kakemus/skaperfestivalen-machine/lasercut/README.md

# Scroll cassette — laser-cut box

The box that holds the paper strip, both spools, the light sensor and the backlight.
It later slides into the arcade cabinet as one unit.

## Files

| File | Material | What |
|---|---|---|
| `cassette_mdf_3mm.svg` | 3 mm MDF, one 570 × 400 bed | front, front doubler, left wall (motors), right wall (axles), top, bottom, back plate, 2 joint-test pieces |
| `cassette_diffuser_3mm.svg` | 3 mm opal / frosted acrylic | the diffuser |
| `make_cassette.py` | — | makes both files; change a number at the top and run `python3 lasercut/make_cassette.py` |

Red lines = cut. Blue = engrave or score (part names, where the motors and the LED matrix go).
Units are millimetres — check the laser software imports at 1:1 (the blue sheet outline is 570 × 400).

**Cut the two TEST pieces first** and push them together. They should slot in firmly by hand.
Too loose or too tight → set `KERF` in `make_cassette.py` (try 0.1), regenerate, test again.

## Cutting the big MDF boards down to laser size

The boards are 1190 × 815 mm, the laser bed 570 × 400. Each board gives **4 pieces**:

```
 1190 ──────────────────────────────────
 ┌────────────────┬────────────────┬──┐
 │   565 × 395    │   565 × 395    │  │ 815
 ├────────────────┼────────────────┤  │
 │   565 × 395    │   565 × 395    │  │
 └────────────────┴────────────────┴──┘
   (≈ 55 mm strip on the right, ≈ 20 mm along the bottom: offcuts)
```

1. Cut across the 1190 side at **565 mm** (a first cut), then again at 565 from that cut.
2. Cut each 565 × 815 strip across at **395 mm**.

565 × 395 rather than the full 570 × 400 leaves a few millimetres so a slightly crooked saw cut
still fits the bed. 2 mm MDF can be scored with a sharp knife against a steel ruler (several
passes) and snapped; 3 mm too with patience, but a table/track saw at the workshop is quicker.

**What goes on which:** the box is 3 mm (one bed piece). The 2 mm pieces are for later parts —
spacers, the coin chute, button plates, test pieces — or a lighter front doubler.

## Box size

Outer 126 × 216 × 95 mm. Window 64 × 90 mm (one screen of the strip shows through it).

## Also needed

- 2 × 6 mm wooden dowel, 126 mm long (paper guides, through both side walls)
- 2 × M3 screw ~16 mm + nuts/washers (spool axles in the right wall; washers fill the gap so the spool can't slide)
- 4–8 cable ties, max 2.5 mm wide (hold the motors to the left wall)
- the 5 mm LDR (goes in the small hole beside the window, sensor face flush with the inside)
- the 8 × 8 NeoPixel matrix (hot glue or double-sided tape inside the engraved square on the back plate)
- wood glue

## Assembly

1. Glue the **front doubler** onto the front panel's outside, holes lined up.
2. Glue **left wall, right wall, top and bottom** to the front with their finger joints.
   The front edge of each is marked. The back stays open.
3. Slide the **diffuser** into the slots halfway back before the second side wall is glued.
4. **Motors**, inside, along the left wall: rear shaft through the 8 mm hole, can pointing to the
   back, inside the engraved outline. Strap with cable ties through the small slots.
   Motor wires out through the round hole behind the motor.
5. **Spools**: push onto the motor shafts; M3 screw through the right wall into the spool's axle hole,
   washers between spool and wall.
6. **Dowels** through both walls, above and below the window. The paper runs in front of them
   (between dowels and front panel), so the screen in the window is flat.
7. **LDR** into the hole beside the window, from the front; legs come out behind the scanner housing.
8. **Back plate**: LED matrix on its inside (engraved square), wires through the slot; slide its
   tabs into the notches at the back of the side walls.
9. Mount the **scanner housing** on the front with bolts through the slots above/below the window.
10. Optional: paint the inside matte black so only the paper glows.

## Unchecked

- TT motor sizes are typical values (70 × 22.5 × 18.8 mm, shaft ~11 mm from the gearbox end).
  Hold a motor against the engraved outline before gluing.
- The scanner housing's own bracket positions weren't measured exactly — the slots are long so
  it can be bolted anywhere along them.

---

# Arcade cabinet — laser-cut box (2026-10-16)

The cabinet the cassette slides into, with the printer, buttons, bell and electronics.
Outer **380 W × 384 H × 260 D mm**. Made by `make_cabinet.py` (change a number at the top, run
`python3 lasercut/make_cabinet.py`). Same joints, colours and units as the cassette.

## Files — one per 565 × 395 laser piece

| File | Material | Parts |
|---|---|---|
| `cabinet_1_front_3mm.svg` | 3 mm | front (cassette opening, button holes), cassette shelf |
| `cabinet_2_back_3mm.svg` | 3 mm | back panel, button doubler, **joint test A + B**, 12 corner-block squares |
| `cabinet_3_sides_3mm.svg` | 3 mm | left side, right side (bell grille) |
| `cabinet_4_bottom_lid_3mm.svg` | 3 mm | bottom (placement marks), printer lid, 4 lid cleats |
| `cabinet_5_top_3mm.svg` | 3 mm | top (opening above the printer) |
| `cabinet_6_printer_shelf_3mm.svg` | 3 mm | printer shelf, 4 wedges |
| `cabinet_7_divider_2mm.svg` | **2 mm** | divider wall |

6 pieces of 3 mm + 1 piece of 2 mm.

## Before cutting

1. **Cut sheet 2 first** and push TEST A and TEST B together — same check as for the cassette.
2. The lid's cut-outs use the measured paper mouth (front edge 35 mm behind the printer's front,
   `MOUTH_FROM_FRONT`) and cover lever (front edge 58 mm back, right end 22 mm from the printer's
   right, `LEVER_FROM_FRONT`). Still: lay the cut lid on the printer and check before gluing.

## Hardware

- 4 × **M3 bolt, 10–20 mm** + 4 × **M3 nut** (back panel) — e.g. from the Clas Ohlson nut & bolt set 40-7042
- Wood glue

## Assembly

1. **Corner blocks**: glue 3 squares per block — hole, hexagon (press an M3 nut into it), hole.
2. **Box**: glue front, sides and bottom (finger joints). Slide the **divider** in (tabs into the
   bottom's slots), then the **cassette shelf** (left wall ↔ divider) and the **printer shelf**
   (divider ↔ right wall), tabs through their slots. Then the **top** (divider tabs into its slots).
   Glue the **button doubler** behind the front (blue box on the front shows where).
3. **Corner blocks** into the four back corners, flush with the back edges, nut side inwards.
4. **Wedges**: glue them in pairs (2 × 3 mm thick), then onto the printer shelf where the blue lines
   are — high end at the front. The printer stands on them; its top ends up level, 1 mm under the
   top surface, inside the top's opening.
5. **Lid**: lay it on the top over the printer, put the 4 cleats into the corners of the opening
   underneath it and glue them to the lid. The lid then drops into place and can't slide. To change
   the paper roll: lift the lid; the printer's cover opens up through the opening.
6. **Cassette** slides in from the back onto its shelf, against the lip of the front opening.
7. **Back panel**: 4 M3 bolts into the corner blocks.
