kakemus/skaperfestivalen-machine/docs/instructable/system-overview.png

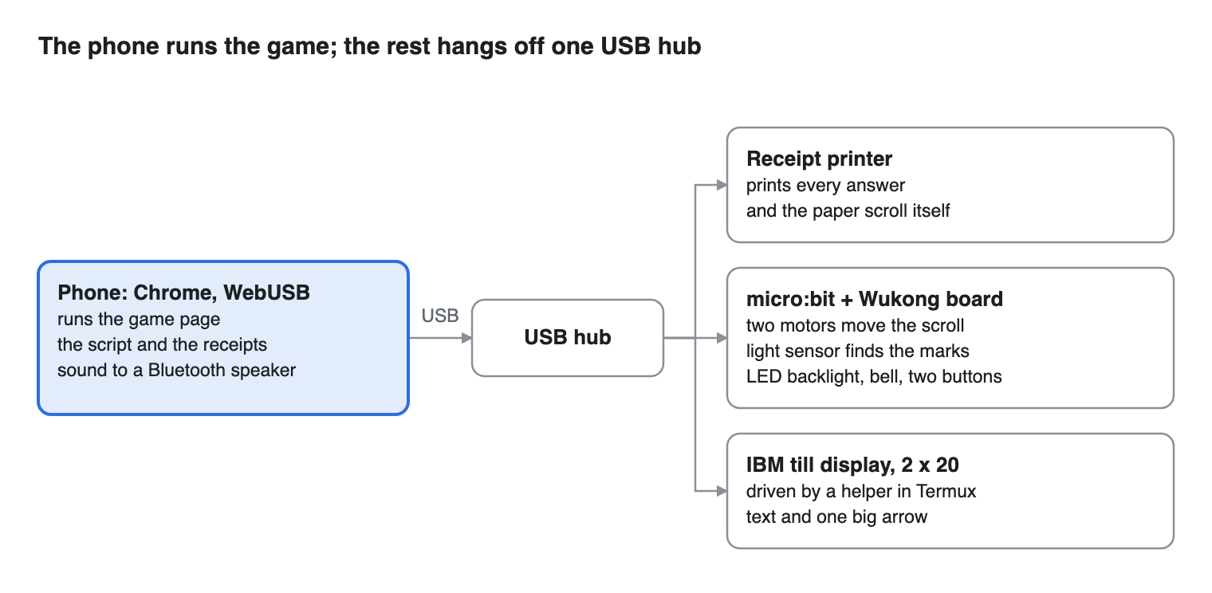
docs/instructable/system-overview.png
