kakemus/skaperfestivalen-machine/docs/scanner-enter-exit-and-reset.png

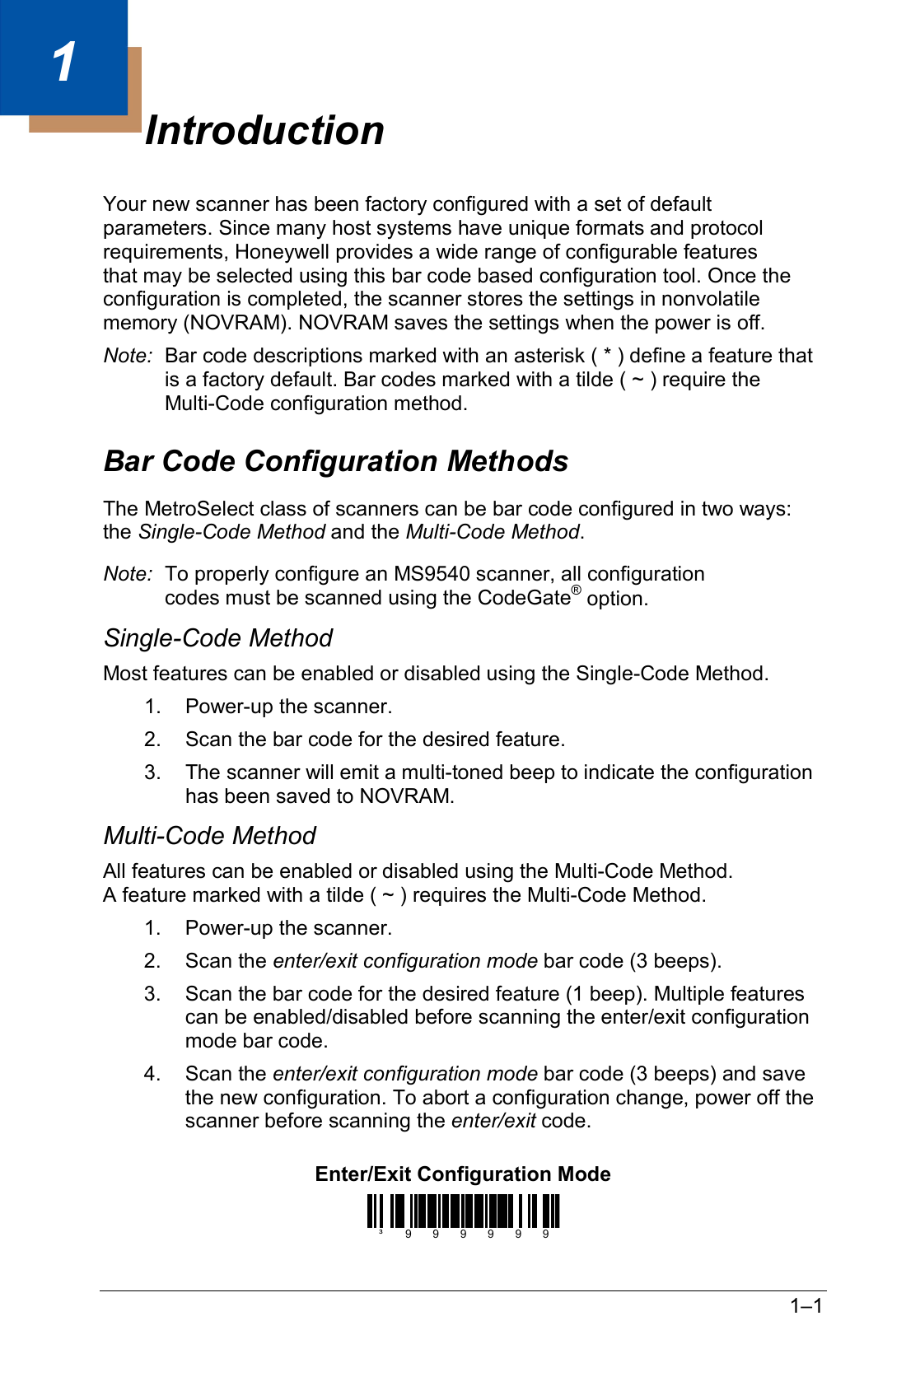
docs/scanner-enter-exit-and-reset.png
