kakemus/skaperfestivalen-machine/screens/template.png

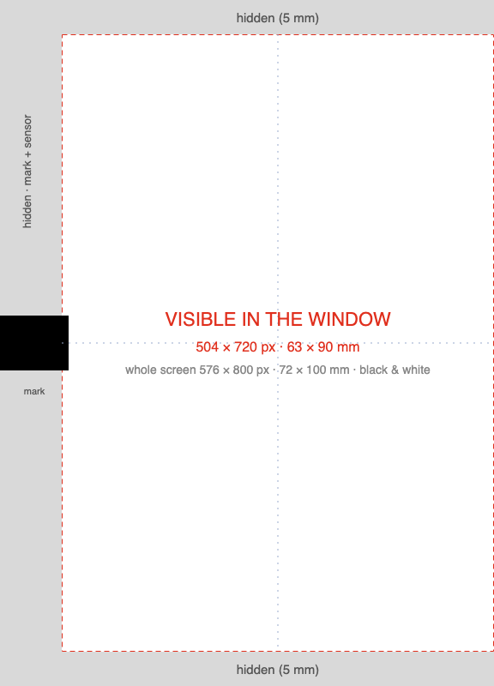
screens/template.png
