kakemus/skaperfestivalen-machine/3d/two_spools.3mf

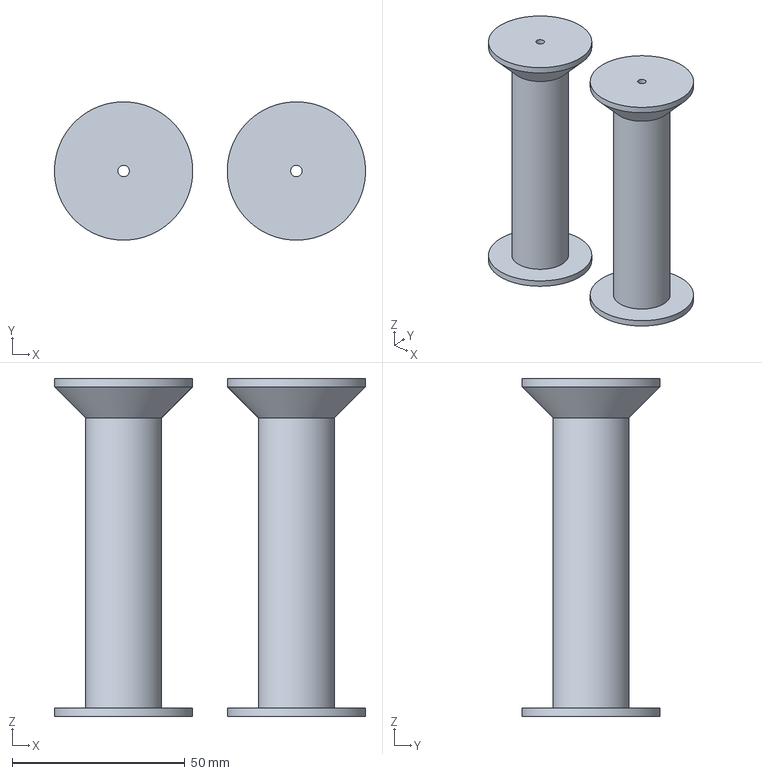
[picture p4: CAD file, 2026-10-05]
3d/two_spools.3mf
90.0 x 40.0 x 97.8 mm
spool x 2
