kakemus/skaperfestivalen-machine/3d/fit_test.3mf

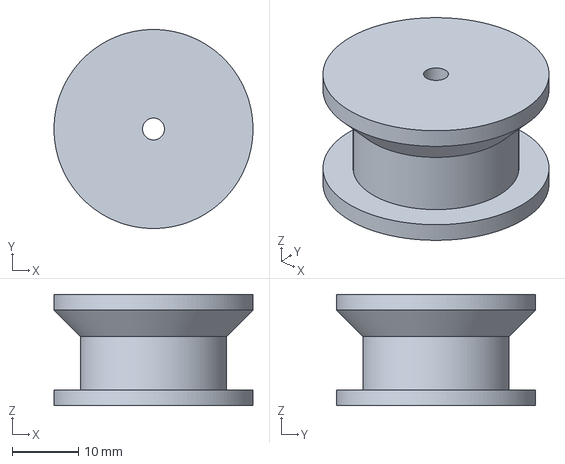
[picture p5: CAD file, 2026-10-05]
3d/fit_test.3mf
30.0 x 30.0 x 16.8 mm
