kakemus/skaperfestivalen-machine/3d/spool.stl

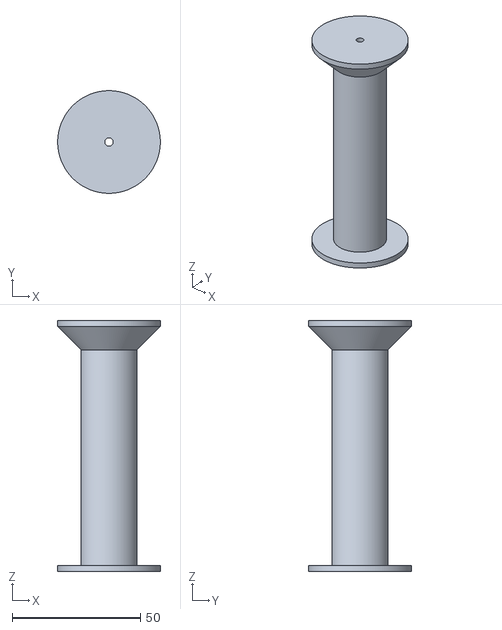
[picture p6: CAD file, 2026-10-05]
3d/spool.stl
40.0 x 40.0 x 97.8
