kakemus/skaperfestivalen-machine/(list of files, cad)

Other CAD files:
3d/two_spools.gcode.3mf
3d/fit_test.gcode.3mf
3d/spool_fit_test.stl
