kakemus/skaperfestivalen-machine/docs/instructable/laser-sheets.png

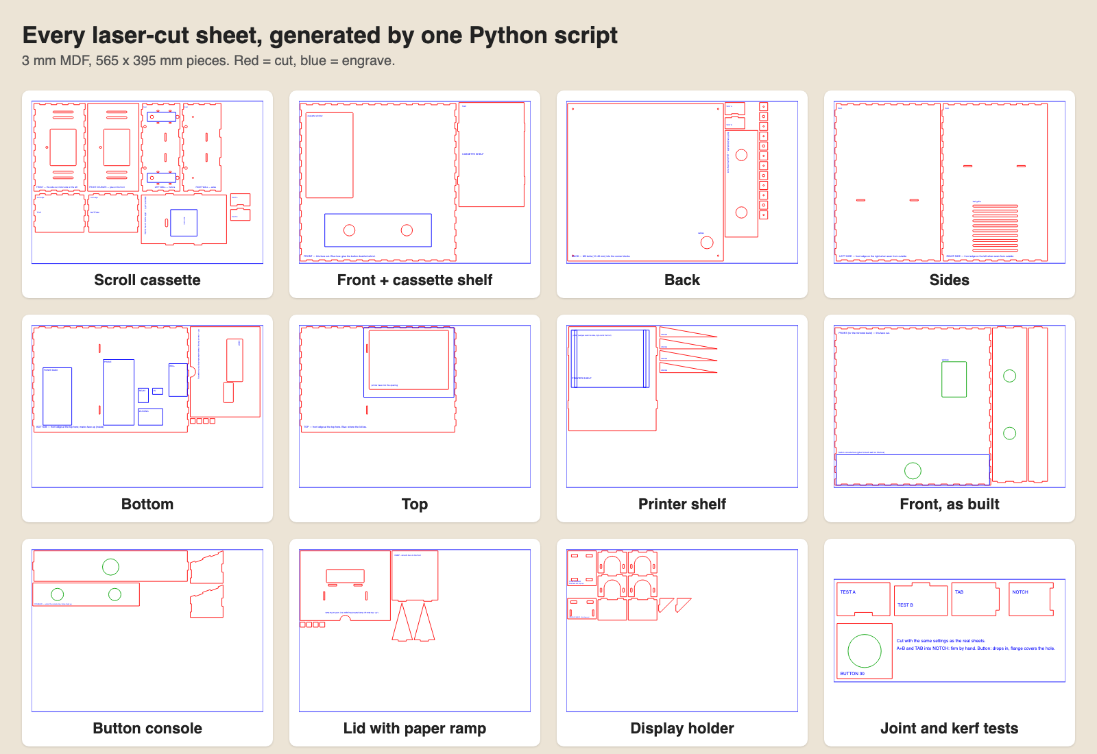
docs/instructable/laser-sheets.png
