kakemus/skaperfestivalen-machine/docs/instructable/receipt-loss.png

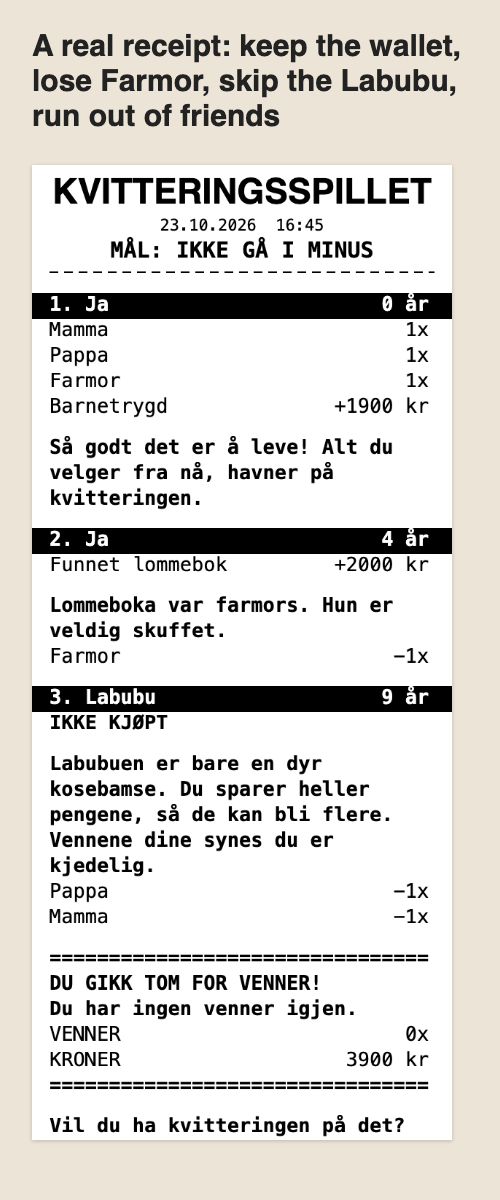
docs/instructable/receipt-loss.png
