kakemus/skaperfestivalen-machine/docs/instructable/strip-screens.png

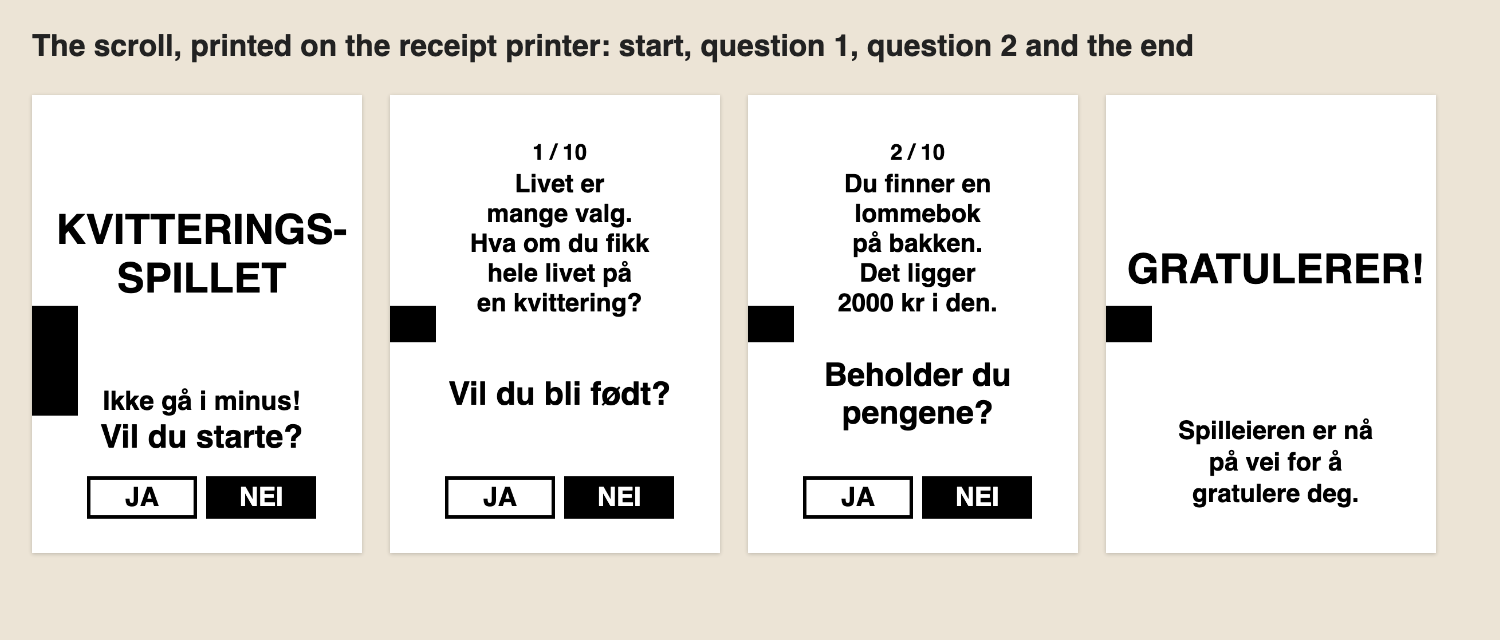
docs/instructable/strip-screens.png
