kakemus/skaperfestivalen-machine/docs/instructable/wiring.png

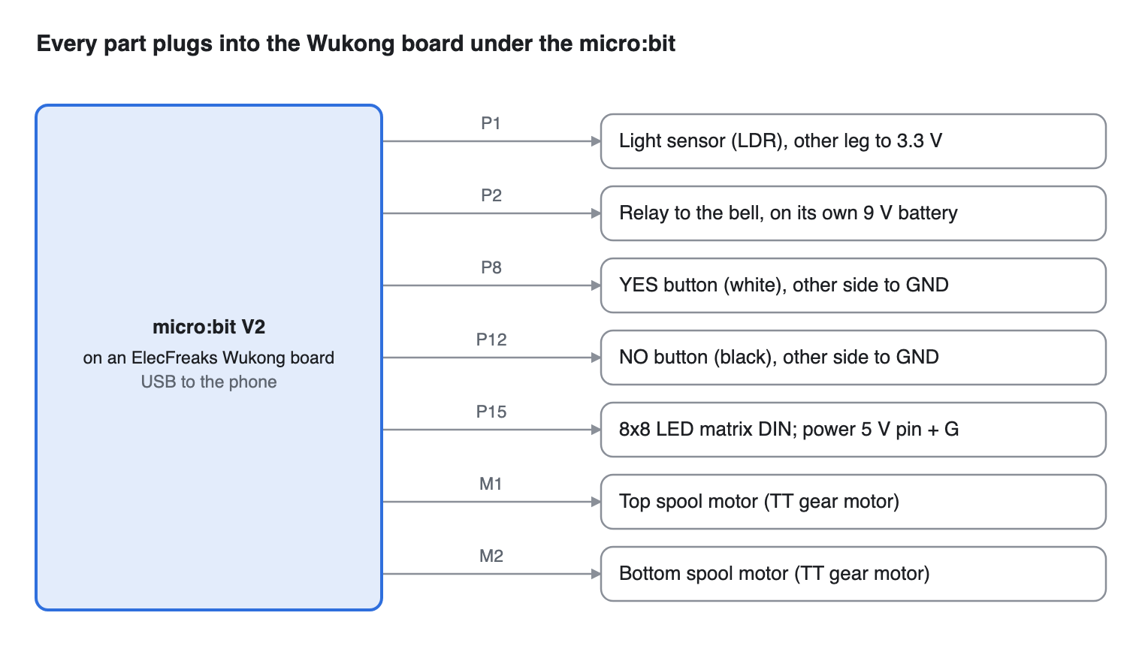
docs/instructable/wiring.png
