kakemus/skaperfestivalen-machine/docs/scanner-setup-codes.png

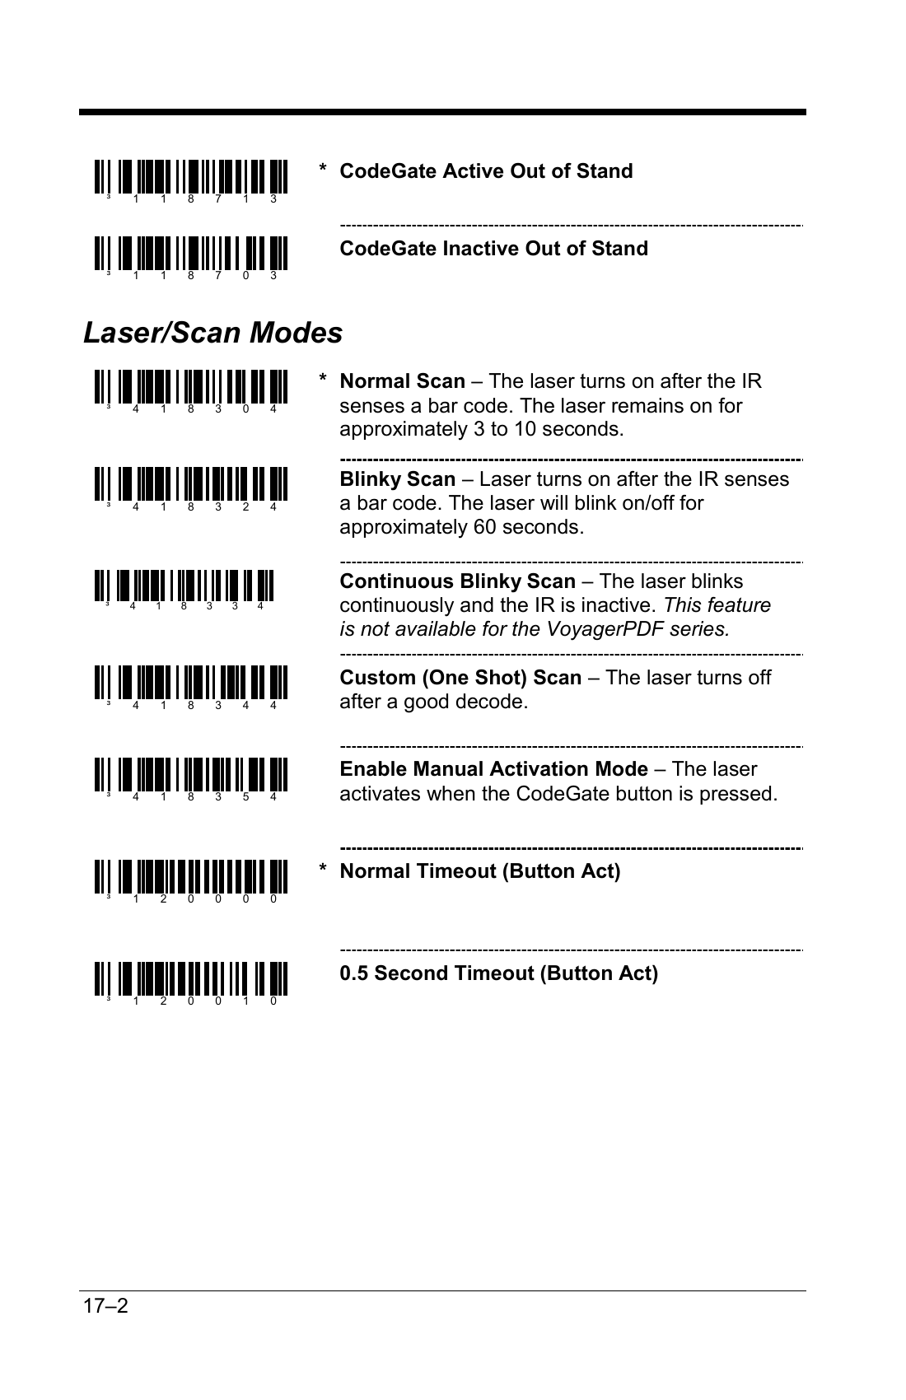
docs/scanner-setup-codes.png
