kakemus/skaperfestivalen-machine/(commit log)

2026-10-02 Start the Skaperfestivalen machine: tickets, IBM display, micro:bit
    A new project for an arcade / slot machine at Skaperfestivalen, split out of
    the occult printer so the two machines never get mixed up. Printer, raster,
    micro:bit and event-bus code are copied (not imported) from there.
    - Printer: fast by default (one transfer per ticket), slow "breathing" mode
    kept as a switch, cut stops a slow print.
    - Ticket designer: pick a design, edit its text, live preview of exactly what
    prints. Three starter designs (prize, fortune, plain).
    - IBM till display over WebHID, from the protocol worked out today by trial
    (never touches its firmware interface), with an on-screen replica and six
    an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
2026-10-02 Six wilder display scenes, and fix a crash on scene switch
    Showcase scenes for the IBM display, each squeezing the 8 custom characters:
    plasma (8 ordered-dither shades), oscilloscope (16 pixel heights across both
    lines), Pac-Man with a ghost, glitch (message breaking into noise and ROM
    glyphs), warp (stars from the middle) and rain (pixel-precise drops).
    The scene clock could hand a freshly started scene a slightly negative time,
    which made the walking bug (and would have made Pac-Man) look up a frame that
    doesn't exist and throw every tick. Clamped to zero.
    Verified: all twelve scenes run 600 simulated frames; each new one checked on
    the on-screen replica; 48 rapid scene switches with no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
2026-10-04 start.command: say why the server failed instead of opening a dead page
    On the maker's Mac a double-click opened Chrome on a page that never loaded:
    macOS privacy protection stopped Terminal from reading the Documents folder
    ("Operation not permitted"), so the server never started. The launcher now
    waits for the server, and if it is not up, prints its error, explains the
    Privacy & Security fix for that case, and waits for a key.
    Verified: script syntax-checked; the hint matches the logged error.
2026-10-04 Notes: the real game concept, replacing a misread sketch
    The maker explained the machine: a yes/no quiz on the IBM display, YES/NO
    buttons, and progress shown as a printed strip moving up behind a backlit
    window on a two-motor belt, with a bell, reward prints and a coin start.
    The notes had guessed a "test your strength" tower; future sessions should
    build towards the real thing. Notes only, no code changed.
2026-10-04 Notes: screens, rewind rule and the motors on hand
    About 10 screens, a wrong answer rewinds the belt, and the hardware is TT DC
    gear motors plus an MG90S servo. Recorded what that implies (driver board,
    separate power, registration marks with a home mark) and the open choice of
    one micro:bit for both spools vs two synced by radio. Notes only.
2026-10-04 The quiz game, playable on screen: coin, ja/nei, belt, bell, rewards
    The machine's actual game, built so it can be played on the laptop before
    the belt exists. A coin (button, C key, or any barcode scan from the
    Metrologic scanner) starts it; the IBM display asks Norwegian yes/no
    questions; a right answer moves a backlit on-screen belt up one screen,
    rings a synthesized bell and prints a reward slip; a wrong answer or running
    out of time rewinds to START; reaching the top prints a "DU VANT!" ticket.
    - belt/strip.js draws the whole printed strip with a registration mark per
    screen (START's is longer), and the sidebar can print it in one go.
    - The same moves go to the machine micro:bit as B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
    [machine.py]
2026-10-04 One tab drives the hardware; scanner detection that doesn't need Enter
    The IBM display turned to garbage and kept dropping out: two copies of the
    page were open and both wrote to it at once. A Web Lock now makes the first
    tab the only one allowed to connect to the display, printer or micro:bit
    (including automatic reconnects); another tab shows a warning and takes over
    by itself when the first one closes.
    A scan also never reached the game. Part of that was the page not having
    focus, but scanners don't all end with Enter, so a fast burst now counts as a
    scan whether it ends with Enter, Tab or nothing, and every scan is logged.
    Verified in the browser: scans ending with Enter, Tab and nothi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
2026-10-04 Scanner setup codes from the MetroSelect guide
    The handheld MS5145 only sends a code when its CodeGate button is pressed;
    the maker wants it to scan by itself. Saved the guide pages with the
    "CodeGate Inactive Out of Stand" code and the enter/exit + recall-defaults
    page (Honeywell MetroSelect Configuration Guide 00-02544) so they can be
    printed, and noted the scanner model in CLAUDE.md. Not yet tried on the
    scanner.
2026-10-04 Print the scanner's setup codes from the app
    The maker wanted the "scan without pressing the button" code on paper without
    hunting for a printer. A new "Scanner setup codes" ticket design (and a
    button under Game) prints the MS5145's MetroSelect codes on the thermal
    printer: CodeGate off/on, enter/exit setup, blinky/continuous/normal scan and
    factory reset. The barcodes are drawn as Code 128 with wide 0.5 mm bars
    rather than printing a picture of the guide page, so a laser reads them
    easily.
    Verified: the guide's own barcodes were decoded from its PDF, and the codes
    the app draws decode to the identical symbols, checksums included (118703,
    418334, 999999, 999998); the button shows the slip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
2026-10-04 Send long prints in 512-row bands
    Printing the ~1.3 m belt strip produced rows of random letters: the whole
    strip went to the printer as one raster image of ~10,000 rows, the printer
    has a limit on how tall a single image may be, and past it falls out of
    image mode and prints the bytes as text. Tickets were short enough not to
    hit it. Fast prints now go out as images of at most 512 rows (6.4 cm), sent
    back to back; the printer lays them end to end with no gap. Slow mode
    already sent 8-row strips and is unchanged.
    Verified with a fake USB printer in the browser: the default strip (10,080
    rows) went out as 20 images, none taller than 512 rows, adding up to the
    full height, and the bits are id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
2026-10-05 Belt test: timed steps without the LDR, and motor test buttons
    The maker has the micro:bits and the Wukong board ready but no light sensor
    wired yet, and wants to try the motors now. The machine firmware gets a
    USE_LDR switch (off for now: a step is a fixed run time) plus MOTOR, LIGHT?
    and PING commands, and the page a "Belt test" section to run each motor
    either way, step up/back and read the light sensor, with the board's
    answers in the log.
    Also checked the Wukong motor command against ElecFreaks' own pxt-wukong
    code (I2C 0x10, [motor, direction, speed, 0]) - identical.
    Verified: firmware syntax-checked; the page's new buttons work and say
    "No micro:bit connected" without one; no consol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
    [machine.py]
2026-10-05 Ready-to-flash micro:bit files; boards show R and M
    The maker isn't a programmer and flashing from here failed (macOS denied
    this session access to the MICROBIT drive), so the firmware now ships as
    .hex files to drag onto the board in Finder. The receiver shows "R" and the
    machine board "M", so the two look different at a glance; the receiver's
    traffic blink moved to the corner so it doesn't break the letter.
    Verified: each hex was built with uflash 2.0.0 and contains its script
    (checked by decoding the hex data). Not yet flashed onto a board.
    [machine.py, receiver.py]
2026-10-05 Machine board keeps running when the Wukong is off
    Flashed onto the real board, the machine firmware died at startup with
    OSError ENODEV: its first motor stop() couldn't reach the Wukong (switched
    off, or the micro:bit not seated), and the whole program stopped. Motor
    writes now catch that, report WUKONG:OFF once (and WUKONG:ON when it comes
    back), and belt/motor commands answer with "Wukong is off" instead of
    silently failing. The page logs these lines.
    Verified on the hardware: receiver flashed and running main.py (checked
    over its REPL); machine board flashed, reports WUKONG:OFF at startup, answers
    PING with PONG and LIGHT? with a reading, and a motor command with the
    Wukong off returns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
    [machine.py]
2026-10-05 Notes: motors confirmed working, and the Wukong seating gotcha
    M1 ran forward and back from the machine board, directly over USB and from
    the page. Recorded that a micro:bit seated the wrong way round in the Wukong
    looks like an empty I2C scan / ENODEV, so the next session checks that first.
2026-10-05 3D-printable belt spool for the TT motors
    The maker asked how to fix the paper strip to the motors. A spool that
    pushes onto the TT motor's double-flat shaft: 80 mm paper between two
    flanges, 22 mm core to tape the strip to, an M3 axle hole at the far end.
    The top flange is a 45° cone so it prints standing up with no supports.
    No 3D software is installed, so make_spool.py writes the STL itself;
    spool.scad is the same part for OpenSCAD, preview.html shows it.
    Verified: the STL is watertight (every edge shared exactly twice), its
    volume matches the hand calculation, and the measured holes are 5.5 mm with
    3.8 mm flats and 3.3 mm; checked visually in the preview. Not yet printed.
    Co-Authored-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
    [spool.scad, spool.stl]
2026-10-05 Strip as a scroll: 20 cm glue-on ends, adjustable
    The maker clarified the strip works like a scroll between two spools, not a
    loop, with extra blank paper at each end to glue to the cores. The leaders
    go from 8 to 20 cm by default with a slider (5-50 cm), and each end gets a
    dashed "LIM HER -> ØVERSTE/NEDERSTE SPOLE" zone so it's clear which end goes
    on which spool. Wording in the sidebar changed from belt to strip/scroll;
    the motor logic already worked this way.
    Verified in the browser: the strip preview shows the glue zone and arrow at
    the top, the info line reads 150 cm with 20 cm at each end, no console
    errors.
2026-10-05 Spool fit-test ring
    The shaft hole is sized from typical TT motor measurements, and printers
    vary by tenths of a millimetre, so a 17 mm ring with just the motor hole
    (about 10 minutes to print) checks the fit before printing two full spools.
    make_spool.py test writes it; the full spool.stl is byte-identical.
    Verified: both STLs watertight; spool.stl unchanged in git.
    [spool_fit_test.stl]
2026-10-05 Ready-arranged 3MF plates for Bambu Studio
    The maker is new to Bambu Studio and the school printer model is not known
    yet, so the STLs can not be sliced here. make_3mf.py packs them into plates
    that open already standing and arranged: two_spools.3mf (two spools side by
    side, centred so they fit any Bambu bed) and fit_test.3mf. At the printer:
    pick the model and PLA, slice, print.
    Verified: both 3MFs parse as valid 3MF; Bambu Studio 2.x --info reads them
    as manifold, 40x40x97.8 mm, 44 cm3 per spool.
    [fit_test.3mf, two_spools.3mf]
2026-10-05 Notes: spool shaft fit confirmed on the school printer
    The fit-test ring printed on the school Bambu P2S fits the TT motor shaft
    snugly, so the spool hole sizes stay as they are; noted how files get to
    that printer (USB stick) and that Bambu Studio's config notice is expected.
    [fit_test.gcode.3mf]
2026-10-05 Live light meter for tuning the LDR
    The light sensor is now on P1, and the belt can only stop on marks if paper
    and mark read clearly differently. Belt test gets a "Live light reading"
    switch that polls LIGHT? four times a second with a bar and number, plus
    "This is paper" / "This is a mark" buttons that judge the difference
    against the firmware's 60 % threshold and say what to change if it's too
    small. Polled readings stay out of the log.
    Verified in the browser with simulated LIGHT: lines: meter shows/hides,
    bar and number update, 820 vs 240 judged clear, 820 vs 600 judged too
    close; no new console errors. Not yet tried with the real sensor.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
    [two_spools.gcode.3mf]
2026-10-05 LDR: use the micro:bit's internal pull-down
    The maker wired the bare LDR from V to P1 with no resistor to ground and,
    in MakeCode, got usable readings with "set pull pin P1 to down". Our
    firmware read 930+ even with the sensor covered. light() now switches the
    pull-down on before every reading (an analog read can clear it), so the
    internal resistor forms the divider. A real 10 kΩ to GND remains the more
    predictable option and still works.
    Also learned: flashing MakeCode onto the machine board replaces this
    firmware entirely (the light meter then got no answers); machine.hex was
    reflashed.
    Verified: firmware syntax-checked, rebuilt hex contains the change, flashed
    onto the machine board (P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
    [machine.py]
2026-10-05 Steady LDR readings: drop the first sample, take a median of 7
    With the internal pull-down the light meter jumped up and down. Logging on
    the board showed the first analog read after switching the pull-down on
    often jumps to ~930 while the following reads are steady. light() now
    throws that first read away and returns the median of 7 more; the page
    polls 7 times a second instead of 4 so the meter feels less laggy.
    Verified on the board: 20 readings at rest read 593-596 (spread 3, was
    hundreds), each LIGHT? answered in ~23 ms. Finger/mark contrast still to
    be checked by the maker with the meter.
2026-10-05 Calibrate the mark threshold from paper vs. mark; switch stop mode live
    The first real paper/mark test read 349 vs 284. The firmware's fixed rule
    (a mark is below 60 % of the paper level) would never fire on that, yet
    with readings now steady to ±4 the 65-step gap is usable in a closed,
    backlit box. So the page's "This is paper" / "This is a mark" buttons now
    send the midpoint to the board (MARKLEVEL:n), a "Stop on marks" switch
    toggles mark-stopping vs. timed steps without reflashing (STOPMODE), and
    both are re-sent whenever the micro:bit connects. The verdict compares the
    gap with the wobble measured at each button press instead of a percentage.
    Verified in the browser with simulated rea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
    [machine.py]
2026-10-05 Snug tug after each move, and motor speeds as sliders
    Keeping the paper tight is now the remaining "sync" problem (one board
    already starts and stops both motors together, and the light sensor decides
    where to stop). After every move the spool that was feeding paper out turns
    back briefly at low power to take up slack, so the window shows a flat,
    tight screen. Pull, feed and rewind speeds and the tug's strength/time are
    sliders in Belt test, sent with SPEEDS:/SNUG: when a slider is let go and
    again whenever the micro:bit connects (the board forgets them on restart).
    Verified in the browser: sliders show defaults (60/45/80, tug 30 for
    120 ms), save, and report when no board is connected; fir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
    [machine.py]
2026-10-06 Laser-cut scroll cassette
    The cardboard prototype works, and the maker has a 600 x 400 laser cutter.
    make_cassette.py generates a finger-jointed box (4 mm plywood, one sheet)
    that holds the spools, keeps the paper flat behind the window with two
    dowels, hides the light sensor and the strip's marks beside a window
    narrower than the paper, carries a 3 mm opal diffuser and a removable back
    plate for the 8x8 NeoPixel backlight, and has a doubled front with long
    slots for the heavy scanner housing. Motors sit inside on the left wall,
    located by their rear shaft through an 8 mm hole. README.md lists parts
    and assembly; two joint-test pieces come first to set the kerf.
    Verified: the generator's fi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
2026-10-12 Cassette files for 3 mm MDF on the real 570 x 400 bed
    The laser's usable bed turned out to be 570 x 400, and the material is
    3 mm and 2 mm MDF boards of 1190 x 815, not 4 mm plywood. The generator now
    takes the bed size as a setting and checks against it, the box is drawn for
    3 mm sheet (outer 126 x 216 x 95, same inside), and the file is renamed
    cassette_mdf_3mm.svg. The README explains cutting each board into four
    565 x 395 pieces.
    Verified: generator fit checks pass, parts use 538 x 360 of the 570 x 400
    bed; sheet inspected in the browser. Not cut yet.
2026-10-12 Belt test page, non-blocking firmware, self-healing connection
    After building the box the maker reported motors that sometimes stop until
    the page is refreshed, single commands that get lost (M1 forward works, M2
    back doesn't), paper falling off the spools, and calibration lost on every
    refresh. Causes found in the code: the firmware slept through every move,
    so commands arriving meanwhile overflowed the tiny serial buffer and got
    cut off, and a page write could hang so every later command queued behind
    it forever. The old "snug tug" only pulled one spool.
    - firmware/machine.py rewritten as a non-blocking state machine: keeps
    reading during moves, STOP any time, BUSY instead of overlappin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
    [machine.py]
2026-10-12 Backlight: 8x8 NeoPixel matrix on P15
    The maker wants to test the LED matrix before the belt. Added to the
    machine firmware (not yet flashed, so this rides along with the
    non-blocking rewrite): the matrix on P15, a "backlight" setting (white
    level, stored on the board, on at boot), LED:ON/OFF/RGB and LED:TEST (red,
    green, blue, white, then back), every channel capped at 120 because 64
    LEDs at full white draw about 4 A. The belt page gets a Backlight section.
    Verified: CPython simulator (boot backlight, test sequence, brightness
    change, RGB clamp, off/on; all earlier belt tests unchanged); the belt page
    against a simulated board (test locks the buttons until LED:DONE,
    brightness saved and se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
2026-10-12 Notes: LED matrix needs the 5V pin, confirmed working
    The matrix stayed dark on the Wukong's red pin rows, which are 3.3 V; it
    works with V+ on the 5V pin of the small middle header and IN on P15.
    The new non-blocking firmware is now on the machine board (heartbeats,
    settings, LED test all answered). Wiring notes corrected in the firmware,
    the belt page and CLAUDE.md; the hex is rebuilt only for the comment.
    [machine.py]
2026-10-13 Kick start for the motors
    M1 "let out" stopped turning while the board kept answering MOTOR:DONE,
    and a nudge on the spool got it going again: at speed 50 a TT motor can't
    always break loose from a standstill against a bit of friction. Every
    motor start (moves, tension, single-motor jogs) now gets full power for a
    moment (setting "kick", default 80 ms, 0 = off) before dropping to the
    asked speed. The belt page shows it under Motors & tension.
    Verified in a simulator of the micro:bit: a jog writes -100 then -50 after
    80 ms, a step kicks both motors then runs 60/45, kick 0 goes straight to
    the speed, mark-stopping and STOP unchanged. Not yet on the board: copying
    the hex to MICROBIT hung agai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
    [machine.py]
2026-10-13 Hold-to-run belt buttons; gentle tightening
    The maker wanted to hold a button to wind the belt up or down while
    testing. Two hold buttons on the belt page send HOLD:1/-1 every 250 ms
    while pressed and HOLD:0 on release (also on STOP, leaving the window or
    hiding the tab). The board runs the belt at its normal step speeds and
    stops by itself 600 ms after the last HOLD, so a lost connection can never
    leave the motors running; letting go tightens the paper.
    Also found while testing: the kick start was applied to the tightening
    tug too - both motors at full power against each other for 80 ms, a yank
    that could tear the paper or pull it off a spool. Tightening is gentle
    again; only real starts g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
    [machine.py]
2026-10-13 Belt: flip each motor's direction in software
    Both motors on the maker's build turned out wired the other way round
    (wind in let out, so up was down). Rather than rewiring, motor() now
    negates the speed when inv1/inv2 is set, so steps, hold, rewind,
    tightening, the kick and the single-motor buttons all flip together.
    The belt page has a checkbox per motor; both start ticked for this build
    and the page pushes them to the board on connect.
    Verified: simulator shows MOTOR:1:50 driving +50 before and -50 after
    SET:inv1:1, TENSION reversed too; belt page loads with no console errors;
    flashed and the board reports inv1/inv2 in SETTINGS.
    [machine.py]
2026-10-13 Belt: brake at marks, settle back onto them, ramped tightening
    The maker saw the belt stop "a while after the mark": the motors coasted
    to a stop, then the tightening tug dragged the paper further. Now a mark
    stop brakes (short reverse burst), tightens, then creeps back until the
    sensor reads the mark again - searching the other way if the tug moved
    the paper the other way - so every screen ends in the same place. The
    board logs how far it had to back up (MARK:back:Nms).
    "Tighten paper" did nothing: a steady 35 without a kick never got a TT
    motor turning. Tightening now ramps from 0 up to the tension strength
    (new defaults 55 / 400 ms; the page migrates the old 35 / 200 once), so
    it starts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
    [machine.py]
2026-10-13 Belt page: send settings one by one; say when a step is timed
    The maker's log showed "ERR:unknown ttle:1500": the burst of SET lines on
    connect overflowed the micro:bit's serial buffer and garbled a line, so
    settings now go out 40 ms apart. The same log showed every step was a
    timed one ("Stop on marks" off), which looked like stopping late at the
    mark - the log now says so on each timed step.
    Verified: belt page loads without console errors.
2026-10-13 Belt: settle smoothly - learn which way the mark is
    With marks on, the maker found it works well but sometimes "rewinds back
    and forth": the settle crept the wrong way for 1.5 s, then the other
    way. Now the edge of the mark counts as on it, each search is 600 ms,
    and the board remembers per travel direction which way found the mark
    and tries that first. The page migrates a saved 1500 to 600 once.
    machine.py outgrew uflash's 20 KB limit, so firmware/strip.py packs a
    comment-free copy for the hex; the source stays readable.
    Verified in the simulator (now with M2 and a tug that drifts either
    way): after at most one "other way" per direction, settles land on the
    first try in ~40-100 ms; stripp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
    [machine.py, strip.py]
2026-10-13 Board owns the belt: Find START, position, service mode; game page slimmed
    The maker wants the belt to run entirely on the micro:bit. The computer
    stays only for the IBM display, the printer and the questions; the game
    now just says step / find START / ring, and the board does the rest.
    - Find START (BELT:HOME): the board runs down until START's long mark,
    learning how long an ordinary mark and a screen take; from the blank
    end it searches back up. Down moves pass through each mark and settle
    onto its top edge, so up and down stops land on the same edge.
    - The board tracks the position and reports it (BELT:DONE:n, heartbeat);
    the belt page shows it instead of counting.
    - Service mod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
2026-10-14 Phone check page: can the old Android phone run the machine?
    The maker wants to try running the machine from an old Redmi Note 7
    instead of a computer. Before changing anything, this page answers it on
    the phone itself: what Chrome there supports (WebUSB / Web Serial /
    WebHID / wake lock), and real tests - print a test ticket (text, a
    picture as the tickets send it, cut), talk to the micro:bit (PING,
    light, bell, belt step), probe the fallbacks - with a Copy results
    report. A tiny server offers just this one page on the Wi-Fi (the dev
    server stays localhost-only); the starter prints the address and the
    Chrome flag needed for USB on a plain-http LAN page.
    Verified: page renders at phone size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
2026-10-14 Phone check: list every USB device Chrome can see
    On the Redmi the printer printed fine over WebUSB, but the micro:bit did
    not appear in the WebUSB picker. An unfiltered picker tells "the phone
    does not see it at all" (cable, power, adapter) apart from "Chrome hides
    it".
    Verified: page loads with no console errors; button present.
2026-10-14 Notes: the old Android phone runs printer and micro:bit over WebUSB
    Records the phone check result (Chrome 87 on Android 10: printer and a
    full belt step both worked over WebUSB, the micro:bit via its CDC serial
    port) and how the test was reached, so the next step - running the game
    from the phone - starts from facts.
2026-10-14 Phone version: the game on the phone's screen, micro:bit over WebUSB, offline copy
    The old Redmi can print and drive the belt (phone check, same day), so
    this is the machine for it:
    - core/usbSerial.js: the part of Web Serial that controller.js uses,
    rebuilt on WebUSB (the micro:bit's CDC serial port). serialApi() uses
    real Web Serial where it exists, so the Mac pages are unchanged.
    - phone.html/phone.js: the same game, belt and ticket modules, with the
    question as big as it fits on the phone screen (whole words), timer
    bar, level dots, attract lines, one tap for full screen + screen on +
    sound, and a hidden operator panel (long press top-left).
    - sw.js + manifest: the phone keeps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
2026-10-14 Belt page on the phone: calibrate live without the Mac
    The maker expects to recalibrate the belt during the festival, so the
    belt page joins the phone version: in the offline file lists, opened
    from the operator panel (same tab, so the micro:bit is handed over) with
    a "Game" link back. "Send log to the Mac" posts the log to the phone
    server, since copying text off the old phone is awkward. CLAUDE.md also
    records the step-by-step plan agreed today.
    Verified: at phone width the belt page fits with no sideways scroll and
    no console errors; Send log arrived on the Mac; all files served by the
    phone server. Not yet run on the phone.
2026-10-14 Phone: a gear button for the panel; fresh version on one reload
    On the phone, holding the top-left corner did nothing (Android Chrome
    cancels a held finger as a gesture), and after several reloads it was
    unclear which version was running. Now a small gear button opens the
    operator panel, the start screen shows the version, and the offline
    copy asks the Mac first (up to 1.5 s) before falling back to the kept
    copy - one reload gets a new version, and it still opens offline.
    Verified: at phone width the start screen shows the version and the
    gear opens the panel; in real headless Chrome a changed file arrived on
    the first load with the server up, and the page and modules loaded
    from the kept c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
2026-10-14 Backlight: a warmth setting, default more yellow
    The maker wanted the backlight more yellow. New board setting "warm"
    (0 = white, 100 = yellow) takes blue out and a little green - the LEDs'
    green is strong, so red + full green reads lime - and applies at once;
    default 70. A number field next to Brightness on the belt page, so it
    can be tuned by eye from the phone.
    Verified in the simulator: SET:warm answers and the matrix gets
    (100, 75, 0) at warm 100 / brightness 100; packed hex rebuilt; belt page
    shows the field with no console errors. Not yet seen on the real LEDs.
    [machine.py]
2026-10-14 Backlight: pick the colour by eye instead of a warmth number
    "Warmth" 70 still looked green on the real LEDs - their green is much
    brighter than their red - so the board now keeps the colour as
    cr/cg/cb (0-255, scaled by Brightness) and the belt page has a colour
    picker that sends it while dragging, so the box changes live. Default
    is an orange-leaning yellow (255, 120, 10), since that is what reads
    yellow on these LEDs.
    Verified in the simulator: SET:cr/cg/cb answer and give (100, 39, 0) at
    brightness 100 for 255/100/0; the rebuilt hex contains the new code (and
    no "warm"); on the belt page the picker shows the default and writes
    255/100/0 for #ff6400, no console errors. Not yet seen on th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
    [machine.py]
2026-10-14 micro:bit connect: a click always shows the chooser; say when it's busy
    On the phone the micro:bit could no longer be picked while the printer
    could. Once a board had been allowed, Connect reused it silently, and
    when opening it failed (another tab still holding it) nothing visible
    happened. Now a click always opens the chooser (only the automatic
    reconnect reuses the known board), and over WebUSB a failed claim closes
    the device again and says what to do: close other tabs, replug.
    Verified: belt page loads with no console errors; a fake USB device
    that refuses claimInterface gives the new message and ends closed.
    Not yet run on the phone.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
2026-10-14 Android: always reach the micro:bit over WebUSB
    On the phone, Connect opened Chrome's serial-port chooser, which found
    nothing: the Redmi's Chrome 87 now reports navigator.serial (the phone
    check said no earlier), so serialApi() picked Web Serial, which can't
    see wired devices there. On Android the WebUSB route - the one tested
    on that phone - is now always used; computers keep Web Serial.
    Verified: with an Android user agent and navigator.serial present the
    WebUSB route is chosen; on the Mac's belt page Web Serial still is; no
    console errors. Not yet run on the phone.
2026-10-14 Green / red flash on right and wrong answers
    The maker wanted the backlight to blink green on a right answer and red
    on a wrong one, before the belt moves. The board does the blinking
    (LED:FLASH:G|R, three blinks, brighter than the backlight) and holds any
    BELT command that arrives meanwhile until the normal light is back - the
    light sensor must never look for a mark in a flash colour. STOP during a
    flash restores the light and drops the waiting move. The game sends the
    flash on a right answer and on a wrong one / time out (game, Mac page
    and phone page); the belt page has Flash green / Flash red buttons.
    A colour per screen was discussed and left for later (it can work if the
    board switches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
    [machine.py]
2026-10-14 micro:bit link: clear USB stalls, reconnect after a broken read
    The phone's belt log: "Controller read error: read stall", then
    disconnected, and every press after that went nowhere (the board was
    still plugged in, so no USB connect event came to reconnect it). Likely
    trigger: backlight 120 in purple from the Wukong's 5 V pin. Now a
    stalled endpoint is cleared and read again (up to 5 in a row), and a
    read that breaks by itself makes the page try to reconnect (5 tries,
    1.5 s apart). The belt page warns about brightness above ~40 on Wukong
    power. (The purple itself was the colour saved on the phone, 255/0/255.)
    Verified with a fake WebUSB micro:bit on the belt page: a stall is
    cleared and HB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
2026-10-14 Belt can't unwind the paper; picked colours look right on the LEDs
    The maker: Find START and the coin rewind often failed and ran so far
    the paper came off the spool. A move without a mark could run for the
    whole 8 s timeout. Now no move runs more than about 1.5 screens of paper
    without a mark (learned screen times up and down, else an estimate);
    Find START from a known position counts the marks back instead of
    having to recognise START, never passes more marks than the strip has
    (new "screens" setting, belt page), and does nothing when already on
    START.
    Picked orange came out yellow: the LEDs are linear and their green is
    strong, so colours now go through a gamma curve (2.6) and green x 0.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
    [machine.py, strip.py]
2026-10-14 English mode, a win light, and coin works right after a game
    Asked by the maker in one go:
    - English mode: game/lang.js holds all the game's words, attract lines
    and ticket texts in Norwegian and English, plus an English question
    list; the phone panel switches language, each with its own list.
    - A win light: LED:WIN, a turning rainbow with sparkles for 6 s, sent on
    a win; belt moves wait for it like they do for a flash.
    - "After winning, coin didn't take the belt back to START": coin was
    ignored for the ~12 s of the win screen and rewind. Coin now starts a
    new game straight away after a win or a loss. The board also queues a
    BELT command that arrives while a move is still finishi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
    [machine.py]
2026-10-14 Bell: through a relay, adjustable length, test buttons
    The maker wired the doorbell (rings on its own 9 V) towards P2. A pin
    can't drive it - and its coil's kick-back spike could damage the pin -
    so the wiring is a relay module (IN on P2, VCC on the 5V pin) switching
    the bell's battery, now in the firmware header and on the belt page.
    New board settings: bellms (power per ding, was a fixed 250 ms) and
    bellinv for relay modules that switch on LOW; P2 is set quiet at start
    either way. Belt page: a Bell section (Ring once / 3 times, length,
    LOW checkbox); phone panel: Ring bell. The game already rings once per
    right answer and three times on a win.
    Verified in the simulator: quiet at start, tw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
    [machine.py]
2026-10-15 Firmware over USB in pieces: the program outgrew the board's memory
    The bell/win-light firmware showed a sad face: "MemoryError: memory
    allocation failed" at start-up - MicroPython parses the whole main.py
    before running it and ~17 KB no longer fit. Precompiled .mpy would avoid
    that, but this MicroPython build can't import .mpy files.
    firmware/upload.py now strips machine.py, cuts it at top-level
    statements into pieces of at most 5 KB and writes them with a small
    loader main.py that runs them one after another in the same globals, so
    only one piece is ever being parsed. It goes over the serial port (raw
    REPL, no soft reset), so no more hanging copies to the MICROBIT drive,
    and the board's s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
    [upload.py]
2026-10-15 Save point: plan for making the belt reliable
    Symptoms seen on the machine (unreliable light sensor, step down stuck on
    its screen, last screen skipped, Find START short), likely causes, and
    the agreed plan (measure with a light trace, mechanics, taller marks,
    code that tolerates a drifting signal) - written down before turning to
    the buttons, so it can be picked up later. Includes the maker's notes:
    taller marks but not wider; black bands near the sensor not the cause.
2026-10-15 Screen template for the maker's own scroll illustrations
    The maker will draw each screen of the scroll themselves. template.png /
    .svg give the exact print size (576 x 800 px = 72 x 100 mm at 8 px/mm),
    the part that shows through the cassette window (504 x 720 px from x 72,
    y 40 = 63 x 90 mm, from the cassette's window 13-77 mm across the 80 mm
    paper and the printer's centred 72 mm print width) and the mark zone,
    plus a short README with the naming convention.
    Verified: the PNG renders at exactly 576 x 800 with the zones in place.
2026-10-16 Cabinet cutting files: the arcade box around cassette, printer and bay
    The maker is starting the box. make_cabinet.py makes one SVG per 565 x 395
    laser piece (6 x 3 mm, 1 x 2 mm), with the cassette's finger-joint code
    so the same fit applies. Outer 380 x 384 x 260 mm (height 384 rather
    than 390 for 5 mm margin on the 395 mm pieces).
    The main design point, from the maker's worry about paper travel: the
    printer stands on wedges that level its sloping top, rises into an
    opening in the top panel, and a lift-off lid with cut-outs for the mouth
    and cover lever lies on top - ~4 mm from mouth to outside, no guide, and
    the printer cover opens through the opening for new rolls. The cassette
    shows thr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
2026-10-16 Cabinet: any M3 bolt 10-20 mm for the back panel
    The maker has Clas Ohlson's nut and bolt set (M3 x 10 up to M6 x 30). The
    holes were already sized for M3 (3.4 mm, nut hexagon 5.7 AF); 10 mm
    reaches the trapped nut (back 3 mm + block layer 3 mm + nut), and longer
    ones end in the third layer's hole. Only the label and README change.
2026-10-16 Cabinet lid: the measured paper mouth position (35 mm back)
    The maker measured the printer's mouth: its front edge is 35 mm behind
    the printer's front (the files assumed 22.5). The lid's mouth and lever
    cut-outs move back accordingly (mouth 44-83 mm from the box front, still
    inside the top's opening and the lid). Regenerated; checks pass.
2026-10-16 Cabinet lid: measured cover-lever position (58 mm back, right side)
    The maker measured the printer's cover lever: front edge 58 mm behind the
    printer's front, at the right (ending 22 mm from its right edge). The lid
    assumed it at the mouth's depth; its cut-out now sits at 67-91 mm from
    the box front, still within the top's opening. Regenerated; checks pass.
2026-10-16 Belt: light trace graph; step-down and flicker safeguards
    First step of the belt-reliability plan (docs/belt-reliability-plan.md):
    measure. TRACE:ON makes the board send the light reading every 20 ms
    while the belt moves; the belt page draws it with the threshold lines
    and the board's decisions, and Send log to the Mac includes the
    readings, so the paper/mark gap, wobble and sensor lag can be seen.
    Two safeguards: a down move that starts on a mark ignores darkness for
    mingap ms (the slow LDR could take the mark it just left for the next
    one), and darkness shorter than 25 ms is logged as a flicker, not a
    mark. The simulator with a slow, noisy sensor did NOT reproduce the
    reported step-down f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
    [machine.py, upload.py]
2026-10-16 Firmware fits the board's file store again: tighter packing, clean uploads
    The light-trace firmware failed to upload: OSError 28, the micro:bit's
    ~16 KB file store was full.
    - strip.py now emits only the spaces Python needs and, with --rename,
    renames the program's own names (never micro:bit or builtin names) to
    1-2 letters; the packed syntax tree must equal the original's with the
    same renaming, and names.txt maps them back to decode board errors.
    17.6 -> 12.5 KB.
    - upload.py clears every file before writing (deleting only the old
    pieces left the store fragmented: the second update ran out of space),
    keeps settings.txt and writes it back, and retries stopping the
    running firm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
    [strip.py, upload.py]
2026-10-16 Buttons: YES + NO (or A + B) together starts a game, like a coin
    Asked by the maker. A quick press of both sends COIN:1; held 5 s it
    still switches service mode (and then doesn't start a game). A lone
    press now waits 150 ms for the other before it is sent as an answer, so
    starting a game doesn't also answer with whichever went down first.
    Verified in the simulator: single YES/NO -> one answer after ~160 ms;
    both together and A+B -> only COIN:1; held 5.5 s -> SERVICE:ON only;
    YES then NO 0.4 s apart -> two answers; the coin switch unchanged.
    Not yet on the board (not plugged in).
    [machine.py]
2026-10-16 Auto-calibrate the light sensor; keep the game log readable
    "Find START fails when you lose" - the phone's game log showed why: paper
    now reads ~205-211 after the backlight was dimmed and recoloured, but the
    threshold was still from the bright light (~500). Everything read as a
    mark, so Find START believed it was already on START and stopped at once
    (BELT:DONE:0 a second after the red flash), and steps found no marks.
    CALIBRATE: the board runs up ~1.5 screens (the blank-paper limit, so it
    passes paper and at least one mark), sets level = midpoint of the
    brightest and darkest readings and hyst = a sixth of the gap, saves, and
    reports CAL:OK:paper:mark:level:hyst (or CAL:FAIL if there's no
    co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
    [machine.py]
2026-10-16 Hold the micro:bit's A + B for 3 s: auto-calibrate, then find START
    Asked by the maker after auto-calibration worked well. Only the
    micro:bit's own buttons (inside the box), not the arcade YES/NO, so
    visitors can't trigger it. The hold blocks the coin and service-mode
    gestures it overlaps with; Find START is queued to run after the
    calibration and dropped again if the calibration fails.
    Verified in the simulator: with a stale threshold, holding A+B 3.5 s
    (and 6 s) calibrates and lands on START, a tap of A+B still starts a
    game, holding the arcade buttons 5.5 s still gives service mode; the
    packed firmware with the real loader matches the source (13.6 KB).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
    [machine.py]
2026-10-16 Cabinet: room for the cassette's motors (25 mm on its right side)
    The maker found the TT motors stick 25 mm out of the cassette's right
    side (seen from the front) - the divider sat 4 mm from the cassette.
    CAS_MOTORS moves the divider to x 162 and the printer column with it
    (213 mm wide, printer 190): printer, top opening, lid, shelves and the
    bay's placement marks follow; the lid's side overlap is 13 mm so it stays
    inside the top. Asserts check the cassette + motors fit and that no bay
    mark crosses the divider. Regenerated; preview checked.
2026-10-16 Cabinet lid: finger notch cut into the lid only, not the bottom panel
    The maker spotted something wrong on sheet 4 before cutting it: the lid's
    finger notch was a whole circle centred on the lid's back edge, so its
    outer half would have cut a semicircle out of the bottom panel lying next
    to it (by the bell mark), and the label ran through it. The lid outline
    is now one path with a half-circle notch, and the label sits clear.
    Verified: rendered sheet 4 - the notch bites only into the lid, the
    bottom panel's edge is untouched; checks pass.
2026-10-16 Hold YES + NO for 10 s to auto-calibrate (no need to open the box)
    The maker would rather calibrate with the arcade buttons than open the
    machine for the micro:bit's A + B. Holding YES + NO: service mode still
    switches at 5 s; held on to 10 s it switches back and auto-calibrates,
    then finds START. Long enough that a visitor won't do it by accident (and
    it's harmless if one does). The micro:bit's A + B for 3 s still works and
    doesn't calibrate twice.
    Verified in the simulator: held 10.5 s -> SERVICE:ON, SERVICE:OFF,
    CAL:OK, BELT:DONE:0; held 6 s -> service only, and off again on the next
    6 s hold; A + B held 12 s -> one calibration, no service; a quick tap ->
    COIN:1. Packed firmware with the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
    [machine.py]
2026-10-16 The life simulator: buy your way up through life, on a printed receipt
    The maker's new concept replaces the quiz on the phone version. Fifteen
    cards, one per screen of the scroll; each is "title | price | JA or NEI |
    losing text": JA cards are purchases to make, NEI cards traps to refuse,
    so JA isn't always right (the maker's call, decided by the story rather
    than random events). The receipt is the only screen: a header at the
    start, a line per card with the running debt, and on a wrong choice or
    a timeout the losing text and the total debt, then cut and back to
    START. The last card is the jackpot: rainbow, bells, an optional ntfy
    push to the maker's phone, the final receipt (their ending, w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
    [machine.py]
2026-10-16 Cabinet assembly manual (docs/cabinet-assembly.html)
    The maker asked for a visual manual to follow at the bench. Fourteen
    steps from the corner blocks to the back panel, in the order that works
    (dry-fit first; divider and shelves before the top; cassette in from
    the back), each with a drawing generated from the cutting files'
    measurements and the part to fit now in blue, plus a parts list per
    sheet. Back views are captioned as mirrored, with a FRONT marker.
    Also published as a private claude.ai page for the phone.
    Verified: the page renders with no console errors; the shell, divider
    and lid drawings checked against the model (right side with the grille
    appears left from behind, the cassette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
2026-10-16 Assembly manual: fix the drawings' hidden parts and labels
    The drawings sorted single faces by their middles, so walls were drawn
    over things in front of them: the button holes and the doubler never
    showed, the lid's cut-outs and the bell were hidden, the cassette sat
    behind the top. Parts are now drawn back to front by a separating plane
    between each pair that overlaps on paper (real outlines, not rectangles,
    which gave contradictory orders; finger-joint overlaps use the axis of
    least overlap). Also: the wedge drawing's "25" was clipped, the lid's
    labels crossed and hit FRONT, step 3 now shows the front from inside,
    step 13 leaves the top out so the cassette and motors can be seen, and
    the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
2026-10-16 Laser files: the 4 nut squares again, to cut without kerf offset
    The laser software's kerf offset shrank the corner blocks' hexagons on
    sheet 2 so the M3 nuts didn't fit. A small 98 x 34 mm file with just
    those 4 squares fits on an offcut; the label on it says to cut with the
    offset off. Same hexagon (5.7 mm across flats) as before. Re-running the
    script leaves sheets 1-7 byte-identical (git shows no change in them).
2026-10-16 Laser files: one button hole, to cut again into the panels already cut
    The kerf offset made the button holes too small, and carving 27.5 mm
    holes round by hand is hard. Cutting a whole new front would use a full
    board piece; instead the cut front (and doubler) goes back in the laser,
    the head is centred on an old hole and this single 28 mm circle is cut
    over it, kerf offset off. Only the red circle is in the file - a blue
    outline would get engraved onto the finished front. Sheets 1-8 unchanged.
2026-10-16 Laser files: roomier hexagons in the nut-square recut (6.1 mm)
    The 5.7 mm hexagon came out too small for the M3 nut even with kerf
    offset off. The nut is glued in between two round-hole squares, so it
    only has to be kept from turning, not pressed in: 6.1 mm across flats
    still sits under the nut's 6.35 mm across corners. Only the recut file
    changes; sheet 2 is already cut and stays as it was.
2026-10-19 Laser files: a new front + doubler for the box as it was built (mirrored)
    The box went together as a mirror image of the drawings (printer on the
    left, cassette on the right, seen from the front), and the front and the
    doubler were stolen. The cassette itself is not mirrored - its motors
    still stick out of its right side - so in the right-hand column it sits
    against the divider with the motors towards the wall, as in the maker's
    photo; the window is placed for that (cassette 1 mm from the divider,
    4 mm lip). Button holes are 28 mm (27.5 came out too small). Holes and
    window are green, to cut with kerf offset off; the outline stays red
    with the offset the finger joints were tuned for. Front +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
2026-10-19 New front: a small window that frames only the cassette's paper
    The maker wants the light sensor (and its tape) and the registration marks
    hidden. The window now follows the cassette's own paper window from
    make_cassette.py (39.7-103.7 mm from its left side, 63-153 mm down from
    its top), 2 mm smaller on every side so a slightly-off cassette doesn't
    show its edges: 60 x 86 mm at x 260.7, 215-301 mm up. The maker's photo
    of the build puts the cassette window at about x 261-326 - within ~2 mm
    of this. To be confirmed with a ruler before cutting.
2026-10-19 New front: 30 mm button holes, to be sure the buttons fit
    The maker asked for 30 mm; the button's flange and nut still cover it.
    Front and doubler, both green (cut with kerf offset off).
2026-10-19 Laser files: a 20 degree button console on the new front
    The maker wanted the buttons angled up towards the player instead of flat
    in the front. A full-width wedge (80 mm deep, 50 -> 79 mm high, top at
    20 degrees) is glued to the bottom of the front: two side pieces with
    notches carry tabs on the sloped top, a front strip and a back wall; the
    back wall gives a big glue face against the front, and a 40 mm cable
    hole through both takes the button wires into the bay. The buttons (30
    mm holes) sit mid-slope with a doubler under them; a 45 mm button body
    still ends ~22 mm above the table. The front loses its button holes.
    Two sheets: 10 (front, console top, strip) and 11 (back wall, sides,
    double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
2026-10-19 Laser files: a test sheet for the new front and console
    The maker asked for tests before cutting sheets 10-11, now that kerf
    offset may be turned off: the finger joint (TEST A+B, as on sheet 2),
    the console's tab-in-notch joint (TAB+NOTCH) and one 30 mm button hole,
    110 x 87 mm. Checked by rendering it.
2026-10-19 Assembly manual: drawn as built (mirrored), with the button console
    The box was built as a mirror image of the cutting files, so the
    drawings now mirror the picture (not the viewpoint, which kept the views
    looking into the box) and every left/right in the text follows the real
    box: printer on the left, cassette on the right, seen from the front.
    New: step 3 builds the 20 degree console onto the new front (sheets
    10-11, test sheet 12 first); the renderer gained straight prisms for its
    sloped parts, with the button holes drawn on the sloped top. The
    cassette sits where it really does (against the divider, motors to the
    wall), the front shows the small window and the cable hole, the old
    doubler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
2026-10-20 Add Kvitteringsspillet, Aksel's script for the machine
    A complete life-on-a-receipt game written in a separate session, added in
    its own folder so nothing else in the project changes. The README explains
    how it could fit the machine (JA/NEI buttons, ES modules, belt screens).
    Checked: the page opens and runs on its own in a browser.
    Claude-Session: https://claude.ai/code/session_01AXoBJh6QH7jHf1Ewhkux3P
2026-10-20 Kvitteringsspillet: the motor and script as ES modules, tested against the prototype
    The machine's pages load native ES modules, while Aksel's prototype motor
    was written for Node. game/kvitteringMotor.js holds the same rules as an ES
    module and game/manus.js the script, unchanged. Both are added to the
    offline copy (sw.js cache v15, phone_server.py).
    Verified: tests/kvittering.test.mjs plays all 55 paths through the game in
    the prototype's motor and the new one and gets identical receipts (a
    deliberately broken motor makes it fail). Also checked: no receipt line is
    wider than 32 characters, at most two answers per question, and in headless
    Chromium both modules load from phone_server.py an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
    [kvitteringMotor.js]
2026-10-20 Kvitteringsspillet: a 60-second life of 67 years, and a simulator
    Aksel's rules for the machine: a whole life is 60 s = 67 years, counted
    only while the player decides (not while the machine prints or moves the
    belt), each answer printed with the player's age, the game over when the
    time is used up ("Tiden er ute. Du ble 67 år."), question 10 "Nei" answered
    with "Vil du ha kvitteringen?", and 15 s after the end for the player to
    take the receipt before the machine is ready again. game/kvittering.js runs
    it through io like the life game; every wait on the printer and the belt
    has a limit, so a stuck device can't stop the machine for the day.
    simulator.html runs the same game with an on-scree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
    [kvitteringMotor.js]
2026-10-20 Kvitteringsspillet: print the receipt line by line, 2 s per line
    Players need time to read: the receipt is the story. The game now hands
    the printer one line at a time and gives each text line 2 s (a blank line
    a quarter of that), with the life clock stopped while it prints; the belt
    shows the next question meanwhile. A printer that doesn't answer is waited
    for once (20 s) and after that only the reading pace is kept, so a stuck
    printer can't stretch one answer into minutes. The simulator types each
    line at the game's pace and shows the next question while printing.
    Verified: tests/kvittering.test.mjs measures 2 s between text lines and
    0.5 s after blank ones with the age unchanged meanwhil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
2026-10-20 Kvitteringsspillet: 0.5 s per printed line, and a printing sound
    2 s per line made a game last minutes; 0.5 s still lets players read the
    receipt as it comes out (blank lines a quarter of that). The simulator now
    makes a thermal printer's "skhsh" for every printed line (printSound() in
    game/sound.js: chopped, band-passed noise), with a sound on/off box.
    Verified: tests/kvittering.test.mjs passes (the fake printer made faster
    than the new blank-line time, and the test now looks for the next
    question every 5 ms instead of 100 ms, which had added up to a year). In
    headless Chromium: text lines 0.50 s apart, blank ones 0.13 s, and 11
    sounds for 11 printed text lines, no errors.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
2026-10-20 Simulator: black and white, a testing panel, time only on the receipt; fix the printer watch
    The simulator is redone in plain black and white (JA black, NEI white),
    without the age and life bar: the time left now only shows on the
    receipt. A testing panel (D, closable) shows kroner, venner, visning, age,
    time left, and per question which answers can still win, with a ✓ / ✗ on
    each answer given — like the panel in Aksel's prototype.
    The panel showed "Skriveren svarer ikke" over and over with a working
    printer: the 20 s watch started for each printed line was never
    cancelled, so it went off later anyway and marked the printer stuck. On
    the machine that would have made the game stop wait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
2026-10-20 Kvitteringsspillet: 5 s between games instead of 15
    The wait after a game was longer than needed to take the receipt; 5 s
    keeps the queue moving. Presses during those 5 s are still ignored, and
    the belt rewinds meanwhile (the machine waits for whichever is longer).
    Verified: tests/kvittering.test.mjs passes (the pause tests use the
    constant; the 10-hour day now fits 725 games). In headless Chromium:
    "Ny runde om 5 s", JA+NEI during the pause ignored, ready for the next
    player after 5.0 s, no errors.
    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
2026-10-20 Kvitteringsspillet on the machine: receipt drawing, question strip, phone.js switch
    The three things the branch left open. phone.js now runs createKvitteringGame
    instead of the life game: JA/NEI answer, JA+NEI (COIN) starts, the operator
    screen shows the question, which button means what, age, kroner and friends,
    and the bar runs out with the life left. game/kvitteringTegning.js sets the
    game's 32-character lines in a monospaced font sized to exactly 32 across,
    with no margins, so the one-line-per-job printing (f407377) joins into one
    seamless receipt; a big title + date on top, and the cut feeds 15 mm past the
    blade first. The scroll gets one screen per question (belt/strip.js
    cfg.screens,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
2026-10-20 Kvitteringsspillet: question 1 stands ready, the first answer starts the game
    Pressing JA and NEI together to start was one step too many: now question
    1 stands on the scroll as soon as the machine is free, and the first answer
    starts the game — the receipt header and that answer are printed, and the
    life clock runs from then on. Nothing is printed and no clock runs while
    the machine waits. After a game the 5 s for taking the receipt come first,
    then the belt rewinds (it used to rewind during the 5 s), then question 1
    is ready again. start() is now only the power-on rewind.
    Fitted to Stener's phone.js wiring (42b0854): the header is still its own
    "Start" print just before the first answer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
2026-10-20 Kvitteringsspillet: check the balance when the whole answer is done
    Aksel wanted the story to come out before the loss: on question 8 "Ja" the
    receipt jumped from the answer line straight to "SPILLET ER TAPT", because
    the motor stopped at the boat's -19000 before the funny part. The balance
    is now checked when all the answer's steps are done: kroner below 0 at the
    end lose; friends removed that weren't there are a debt that friends added
    later in the same answer pay off, else they lose; death still stops at
    once. Under the new rule the boat's pawn (9500) would have saved players
    who couldn't afford the boat, so it is 50 kr now — the richest player who
    can't afford it has 18 900 kr before q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
2026-10-20 Phone panel: the controls in use on one page, most used first
    The maker found the panel bloated: belt jobs needed a trip to the belt
    setup page with all its light-sensor, motor and test settings. The phone
    panel now has, top to bottom: Close + a red STOP; printer / micro:bit /
    belt position; the belt (step up/down, hold to wind up/down, Find START,
    Auto-calibrate — the same board commands as belt.html, holds repeated
    every 250 ms like there); the game (Reset game, JA/NEI, test print, cut,
    bell, win light); the log; the strip. The game description, push settings,
    version and the link to all belt settings sit in a closed "More" at the
    bottom, so nothing is gone. belt.html itself is unchanged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
2026-10-20 Scroll pictures: the maker's eight pictures on the question screens
    The maker found pictures for questions 3-10 (bilder/NN-name.png, named
    after manus.js's "bildefil"). They're all on plain opaque white, so each is
    prepared once in game/kvitteringTegning.js: a flood fill from the edges
    finds the background (a white object with any shading at its edge stays),
    the picture is cropped to the object and fitted into a 464 x 278 area,
    levelled (gamma 0.85), and Floyd-Steinberg dithered (raster.js's, now
    exported). Per picture: the white microscope gets a black outline round
    the object, the red chair and the brown cabinet a lighter gamma - they came
    out almost solid. belt/strip.js draws a screen's r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
2026-10-20 Strip screens: content moved into the part the front's window really shows
    The maker's photo of the first printed strip in the machine: the front's
    window sits about 5 mm left of where it was drawn, so roughly 5-65 mm of
    the paper's width shows - text past ~65 mm was cut off on the right and
    the mark's right half showed on the left. Re-cutting the front would mean
    rebuilding the console glued to it; re-printing the strip is quicker. The
    screens' content area is now 12-62 mm of the paper (WIN x 96, w 400), the
    pictures 400 x 240 to match. Cache v21.
    Verified in Chrome: screens 1, 2 and 8 drawn with the hidden parts (from
    the photo) shaded - all text, pictures and the answer band inside.
    Co-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
2026-10-20 Phone: feed each answer up into view, and Tighten paper back on the panel
    The maker's photo: the print head sits well below the printer's slot, so
    an answer's last lines stayed inside the printer while the player was
    supposed to read them. After each answer (when the game moves on to the
    next question, which it does only once the answer is printed) the phone
    now feeds 20 mm of paper; "Space under each answer (mm)" in the panel's
    Game section changes it (0-60, kept on the phone). The belt section has
    "Tighten paper" again: the board's TENSION command, as on belt.html
    (answers TENSION:DONE, or BUSY while moving). Cache v22.
    Verified in Chrome: a first answer printed as Start, the answer's lin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
2026-10-20 Phone: 30 mm under each answer instead of 20
    The maker's photo with 20 mm: the answer's last line was still under the
    printer's slot, about 1.5 lines short. 30 mm brings it up into view.
    (A value typed into the panel stays as it is.) Cache v23.
2026-10-20 Kvitteringsspillet: a life of 10 minutes instead of 60 seconds
    Testing on the machine, 60 s for the whole life - about 6 s a question,
    reading included - was far too short, and felt like the timer wasn't
    working. The maker chose to keep the idea (one clock for the whole life,
    running only while the player decides, 0 to 67 years) and make it 10x
    longer: LIVSTID_MS 600000, about a minute a question. The light's hurry
    flicker still covers the last 10 s. Two tests had 6 s = 6 years and
    3 s = 3 years written in; they now take the time from LIVSTID_MS and
    LEVEALDER, so they hold for any life length. Texts updated (comments,
    README, CLAUDE.md, the phone panel). Cache v24.
    Verified: node tests/kvit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
2026-10-20 The IBM till display on the phone: a Termux helper, and the game's countdown
    The maker wanted the life's countdown on the old IBM display. Android's
    Chrome has no WebHID and blocks HID devices from WebUSB, so a helper in
    Termux on the phone owns the display instead (tools/termux-ibm/: termux-usb
    hands it the device, libusb via ctypes, Android's HID driver detached; a
    small HTTP server on 127.0.0.1:8765). It writes only to the interface whose
    report descriptor has usage 0x2600 and not 0xA000. The display's font has
    no Æ Ø Å, so the helper draws them as custom characters 1-3.
    game/kvitteringDisplay.js turns the game's state into the two 20-character
    lines: KVITTERINGSSPILLET / SVAR JA ELLE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
2026-10-20 Kvitteringsspillet: belt waits for the receipt, 4-minute life, age instead of a timer
    From playing it on the machine: the next question ran ahead of the answer
    still printing, so the belt now moves on only once the answer is printed
    (and the phone first feeds it up out of the slot, via its belt.step, so it
    can be read while the next question comes). The life is 4 minutes (the
    clock still stops while printing). And the IBM display no longer counts
    down: it shows DU ER nn ÅR growing while the player thinks, the money or
    friends below, and SKYND DEG! blinking in the last 10 s - getting older is
    more fun to watch than a timer. Cache v27.
    Verified: node tests/kvittering.test.mjs, all ok; in Chr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
2026-10-20 IBM display: the age ticks up live; the life back to 3 minutes
    The display showed the game's own age, which only moves on with an answer,
    so it stood still while the player thought. It now works the age out from
    the life used so far (game.igjenMs counts the question being decided), so
    it climbs every ~2.7 s while the player hesitates and stops while the
    machine prints. The maker went back to a life of 3 minutes. Cache v28.
    Verified: the display lines for 180/179/150/90/2 s left (0/0/11/33/66 years)
    in node; node tests/kvittering.test.mjs all ok.
2026-10-20 Phone: a micro:bit watchdog that resets a board gone deaf
    Twice on 2026-10-20 the board stopped reacting mid-game: "M" on its LEDs
    (its idle screen), still connected over USB (Android's USB log showed no
    drop), no answer to any command until its reset button was pressed. The
    cause isn't known yet. So the phone now PINGs it every 5 s; after two
    unanswered in a row it logs when the last heartbeat came, resets the board
    the way its button does - a serial BREAK, on which the micro:bit's USB chip
    (DAPLink) restarts it (usbSerial.js sendBreak, controller.js resetBoard;
    Web Serial's setSignals on a computer) - and puts the game back on START,
    since the board lost its place. The panel shows "not ans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
2026-10-20 Phone panel: a Reset micro:bit button
    The same serial-break reset the watchdog uses, by hand - so it can be
    tried on the board without waiting for the next freeze. Cache v30.
2026-10-20 Watchdog: one automatic reset only, and the break ended for sure
    On the machine the first automatic reset didn't bring the board back, and
    the watchdog then reset it every 15 s for minutes - it never got to start,
    and the maker's own reset-button press was overridden. Now it resets once;
    if the board still doesn't answer it only says so (unplug and replug), and
    tries again only after the board has answered once more. The break is
    also explicitly ended (SEND_BREAK 0) after its 100 ms, in case a break left
    on held the board in reset. Cache v31.
2026-10-20 Phone log: keep 1500 lines instead of 150
    The log sent after a good session covered only its last minute and a half -
    too short to tell whether the board froze earlier on. Cache v33.
2026-10-20 Phone panel: the Termux command for the IBM display, with a Copy button
    After a phone restart the display's helper has to be started by hand in
    Termux; the panel now shows the command under the IBM display line, and a
    button copies it for pasting there. Cache v34.
2026-10-20 IBM display helper finds the display by itself
    "No such device": the display had been replugged and its USB path had
    changed, and Termux can't read the USB list to find the new one. The start
    script now tries each device termux-usb lists (the last path that worked
    first) with ibm_bridge.py --probe, which only reads the device descriptor,
    until one is 04b3:4526. The phone server serves the two helper files and the
    panel copies a one-line update command; the start command no longer takes a
    path. Cache v35.
2026-10-20 JA + NEI held 5 s: auto-calibrate and put the game back on START
    The maker wanted a 5 s hold of the arcade buttons to calibrate and reset
    the game. In the firmware, 5 s used to toggle service mode (S on the
    display, YES/NO winding the belt) with calibration at 10 s; service mode
    isn't needed from the buttons any more (the phone panel has hold-to-wind),
    so its button toggle is gone and calibration is at 5 s (CAL_ARCADE_MS);
    the hold no longer gives a coin on release. 220 bytes smaller packed
    (14184). On the phone, a calibration's end - CAL:OK then the board's own
    find-START reply, or CAL:FAIL - now resets the game, so it doesn't go on
    from where the belt used to be; the panel's Auto-calibrate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
    [machine.py]
2026-10-20 Watchdog: heartbeat-based, faster, and the game goes on after a reset
    The log of the next freezes (19:52, 19:58): the board's heartbeat stopped
    while a player was thinking, only with the IBM display on the hub; the
    automatic reset brought it back in 4 s, but the game started over. Now
    the watchdog goes by the heartbeat the board sends every 2 s anyway
    (instead of its own PINGs): 5 s without one → one reset (serial break);
    if the belt was standing still (ready / deciding), the board is told which
    screen it's on (POS) and the game simply goes on; during a move it goes
    back to START as before. Still only one automatic reset until the board
    is heard from again. Cache v38.
    Verified: the page l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
2026-10-21 Losing is unmistakable: a long red flash at once; the win rainbow longer
    The maker: losing has to be super clear. An answer that ended the game
    only flashed red after its whole receipt had printed (several seconds
    later), and then just 3 short blinks. Now the game signals the end the
    moment the answer is pressed - red for a loss, the rainbow + 3 bells for
    a win - before the lines print (signalEnd; time running out still signals
    in over()). The red is 12 blinks (~3.6 s): the firmware's LED:FLASH takes
    an optional count (LED:FLASH:R:12; old firmware ignores it and blinks 3).
    The win rainbow lasts 10 s instead of 6. Cache v39.
    Verified: node tests/kvittering.test.mjs all ok; in the firmware si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
    [machine.py]
2026-10-21 Long red / win light from the phone instead of new firmware
    The maker would rather not update the micro:bit for this (it's fiddly), so
    the flash-count and longer-rainbow firmware change is undone; the game's
    change stays (the end is signalled the moment the deciding answer is
    pressed). The phone now sends the board's own red flash 4 times back to
    back (~3.6 s) for a loss, and LED:WIN again after 5 s (~11 s of rainbow)
    for a win - same effect, old firmware. Cache v40.
2026-10-21 Firmware back to what's on the board; the changes kept as patches for later
    The maker wants one micro:bit update later rather than one per change, so
    firmware/machine.py is back to exactly what runs on the board (the 5 s
    calibrate change undone, its texts too; the phone's hint says 10 s). Both
    firmware changes from 2026-10-20/21 are kept in firmware/pending/ as
    patches, with a README saying what each does and what to update with it.
    The phone side that goes with the 5 s change (resetting the game after a
    calibration) stays: it works with the 10 s hold too.
    Verified: firmware/machine.py identical to its state before the 5 s change
    (git diff 3bf05a7~1, empty); packs to 14404 bytes as before.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
    [machine.py]
2026-10-21 Pending firmware: 5 s hold does nothing, 10 s calibrates (replaces the 5 s-calibrate patch)
    The maker settled on: JA + NEI held 10 s = auto-calibrate + find START (as
    now), and 5 s = nothing (no more service mode from the buttons). Kept as
    firmware/pending/no-service-mode.patch for the one later micro:bit update;
    firmware/machine.py stays what's on the board. Checked by applying it to a
    copy in the firmware simulator: 6 s hold gives only a COIN on release (the
    game ignores COIN), 11 s gives CAL:OK + BELT:DONE:0, a quick press of both
    a COIN, one button an ANSWER.
2026-10-21 Laser files: a new printer lid with a paper ramp (sheet 13)
    On the machine the receipt came up out of the lid's slot and fell
    backwards, flat on the lid. The new lid has a backrest standing 4 mm
    behind the paper slot, 112 x 120 mm, leaning back 15 degrees, held by two
    triangle braces behind it, all with tabs into slots in the lid (the
    backrest's slots are wider for the tabs going through at an angle) - the
    receipt rises along it facing the player. The lever cut-out is gone. The
    slot is centred across the lid and smaller (92 x 32 mm instead of 104 x 39;
    the paper is 80 mm wide), on the old slot's centre line from the front -
    the maker, from a photo: "depth is good", the printer can be shifted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
2026-10-21 Laser files: a holder for the IBM display's pole (sheet 14)
    The maker hangs the display from its pole (foot up, head down - the text
    then reads right), its top edge 100 mm under the box's top edge; with ~21
    cm of pole from the foot to the display's top edge, the foot ends up ~11
    cm above the box, clear of the lid. The foot can't come off and the head
    is at the other end, so the pole can't go through closed rings: two
    U-shaped arms open at the front (40 mm for the 39 mm pole, its axis 30 mm
    out, 10 mm of MDF behind it), each two layers glued (6 mm), tabbed into a
    70 x 85 mm mounting plate glued to the front panel's top 10 cm wherever
    the pole goes; a strap (velcro / cable tie) through slots i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
2026-10-21 Display holder: a shelf under the display, so it can't slide down
    The maker asked what keeps the display at its height: only the strap's
    grip, which could creep. Sheet 14 now also has a small shelf the display
    rests on (its underside is flat): a 70 x 50 back plate glued to the front
    panel, the 70 x 50 shelf in two layers tabbed into it, and two triangle
    braces under it tabbed into the back plate. The weight goes into the
    shelf; the U-arms only keep the pole upright, and the shelf's height sets
    the display's.
    Checked by rendering the SVG, and the slot positions against the parts'
    tabs (the braces' slots were first 12 mm too high - fixed).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
2026-10-21 More paper under each answer, and the IBM display points at the receipt
    From user testing: children see the receipt from lower down, so each answer
    now gets 50 mm of paper under it (was 30; the panel field still changes it).
    And the display makes clear the receipt is the thing to read and take: while
    an answer prints and after the game ends, its bottom line takes turns with
    "^ LES KVITTERINGEN ^" (^ pointing up at the printer above it); during the
    5 s pause and the rewind it shows "^ TA KVITTERINGEN! ^" with "OG TA DEN
    MED DEG" / "TAKK FOR SPILLET". Cache v41.
    Verified: the display lines for each state checked in node (all 20
    characters or fewer); node tests/kvittering.test.mjs all ok.
    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
2026-10-21 Phone: 40 mm under each answer (50 was a bit much)
2026-10-21 Phone: a wrong-answer buzzer when the player loses
    The maker wanted a sound for losing, from the phone: a classic game-show
    "BZZZT" rather than a sad trombone - two square waves at 120 / 127 Hz
    beating against each other, low-passed at 1.8 kHz so a small speaker
    doesn't just crackle, about 1 s. It plays with the red light, the moment
    the losing answer is pressed (or time runs out). Cache v43.
    Verified: rendered offline in Chrome - sound from 0.03 to 0.97 s, peak 0.84
    (no clipping); not yet heard on the phone.
2026-10-21 From the user test: the display points at the receipt, clearer losing, more bell
    The maker's user test: with three screens talking at once (the scroll,
    the receipt, the IBM display), people got confused. So:
    - The IBM display, from the moment an answer is pressed, says how it went
    (RIKTIG VALG! / DU LEVER VIDERE, or GAME OVER / FEIL VALG / TILBAKE TIL
    START, a word a second) over a still LES KVITTERINGEN with blinking ^
    arrows pointing up at the printer; the pause shows TA KVITTERINGEN!.
    - Losing: the belt rewinds as soon as the red flashing is over (ROD_MS
    4 s after the loss), while the receipt still prints, instead of after the
    5 s pause; a win keeps the pause. New test for it.
    -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
2026-10-21 Losing sound: "eeh - aawh" three times instead of a buzz
    The maker wanted "eeh aawh, a couple of times in sequence" rather than a
    buzzer: a sawtooth through a resonant low-pass - a bright high note (eeh,
    440 Hz, cutoff 2.6 kHz), then a lower one sliding down with the vowel
    closing (aawh, 330 -> 250 Hz, cutoff 1.5 -> 0.6 kHz), three times, each a
    little lower; ~2.3 s. Cache v45.
    Verified: played on the Mac from the same recipe; not yet heard on the phone.
2026-10-21 Losing sound: a buzzing two-tone alarm, eeh - aawh three times
    The maker: same "eeh-aawh" three times, not so high, still buzzing, like
    an alarm. Each tone two square waves 7 Hz apart (the buzz), eeh 294 Hz,
    aawh 220 Hz, 0.3 + 0.45 s, three times the same with a short breath
    between; ~2.6 s. Cache v46.
    Verified: played on the Mac from the same recipe.
2026-10-21 Losing sound: deeper and mechanical - a rattling buzzer
    The maker, testing with a real speaker: more mechanical, more of a buzzer,
    deeper. eeh 150 Hz / aawh 110 Hz (two squares 4 Hz apart each), chopped at
    50 Hz by a square LFO on the gain - an old electric buzzer's armature
    rattle - three times. Cache v47.
    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
2026-10-21 Losing sound: the maker's own sound file, a little lower, twice
    The maker found a sound (lyder/tap.mp3, 1.1 s; it arrived as
    belt/"lyder:tap.mp3" - a "/" typed in a Mac file name) and asked for it
    pitched down once and played twice in a row. The phone decodes it once
    (on the first tap; the callback form of decodeAudioData for Chrome 87) and
    plays it at playbackRate 0.8 - about 4 semitones down - twice back to back,
    ~2.7 s. The synthesized buzzer stays as the fallback until the file is
    loaded, or if it can't be. In the offline copy and the phone server's list
    (audio/mpeg). Cache v48.
    Verified in Chrome: the file decodes (1.06 s), buzzer() plays with no
    errors; previewed on the Mac (ffmpeg, t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
2026-10-21 Firmware update on the board: 5 s hold does nothing, flash counts, longer win rainbow
    The batched micro:bit update the maker planned for after user testing:
    both pending patches applied to firmware/machine.py and uploaded
    (update-microbit.command's firmware/upload.py; settings.txt kept). A 5 s
    hold of JA + NEI no longer switches on the old service mode, 10 s still
    calibrates; LED:FLASH takes an optional blink count; the win rainbow lasts
    10 s. firmware/pending/ is empty again; belt.html and CLAUDE.md updated.
    Verified: in the firmware simulator (6 s hold - only a COIN on release,
    11 s - CAL:OK + BELT:DONE:0, quick press of both - COIN, one button -
    ANSWER; LED:FLASH:R:12 holds a move ~3.6 s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
    [machine.py]
2026-10-21 Laser files: JA / NEI signs for the console (sheet 15)
    From the user test: people didn't know which button was which. Two 30 x 20
    mm plaques (JA for the left button, NEI for the right) plus a spare of
    each, the letters engraved filled - drawn as block-letter polygons, so no
    font is needed in the laser software - and the outline cut. Meant to be
    glued on after painting, the burnt letters dark on bare MDF.
    Checked by rendering the SVG.
2026-10-21 IBM display: the life's clock next to the age
    The maker wanted both, if there's room: "DU ER 12 ÅR 2:41" on the top
    line while the player decides - the age as of the last answer, the clock
    counting down (it stands still while the machine prints, as the life does);
    "SKYND DEG!" keeps the clock in the last 10 s. Cache v51.
    Verified: the lines in node (20 characters).
2026-10-21 Phone panel: Losing sound / Ding sound test buttons
    To check the speaker and its volume without playing a game: the panel's
    Game section plays the losing sound (lyder/tap.mp3, as in a game) or the
    phone's three dings. Cache v52.
2026-10-21 A backup of the micro:bit's settings (2026-10-21)
    Read off the board with SETTINGS? while it was on the Mac, so the
    calibration, speeds and bell settings can be put back if the board is ever
    wiped or swapped. No change to the board.
2026-10-21 Phone panel: live light reading back; the lure waits 5 minutes
    The light sensor read 0 all the time (a loose wire or the backlight) and
    the panel had no way to see it any more since the belt page's tools moved
    out. "Live light reading" in the Belt section turns on the board's
    STREAM:ON (LIGHT:n every 150 ms) and shows the number, a bar, and the
    calibrated threshold as a red line (from SETTINGS?); it turns off when the
    panel closes, so it never runs during a game. The idle lure now starts
    after 5 minutes instead of 1. Cache v54.
    Verified in Chrome: without a board the button refuses and stays off; a
    SETTINGS line places the threshold line; the page has no errors. Not yet
    with the board.
    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
2026-10-21 Phone: only the real bell dings; the phone's ding as a switchable backup
    The maker: the speaker shouldn't ding, the bell is enough. The game's
    bells (right answers, the win, the lure) now ring only the real bell; a
    checkbox in the panel's Game section turns the phone's ding back on as a
    backup if the bell breaks (kept on the phone, off by default). The panel's
    Ring bell no longer dings the phone either; Ding sound still tests it.
    Cache v55.
2026-10-21 Phone panel: only the start command for the IBM display up front
    The maker read the panel as the display needing the Mac every time it's
    reconnected. It doesn't: bash ~/start-display.sh finds the display by
    itself. The "update the helper from the Mac" button moved into More, with
    a line saying it's only for when the helper itself has changed; the start
    command says "no Mac needed". Cache v56.
2026-10-22 Lure after 5 min idle: a switch, off for now
    At home the lure (display blinking TRYKK JA ELLER NEI, white flashes and two bell rings every
    30 s after 5 min with nobody playing) is just annoying; the maker wants it back at the
    festival. New panel checkbox (settings.lure, default off) gates the flashes, the bell and
    the display text; ticking it brings everything back as before.
    Verified on the Redmi, reloaded and started from the Mac: phone 2026-10-22 b, box
    unticked, full screen, printer and micro:bit connected.
2026-10-22 Rescue: taps Android's USB boxes and Chrome's chooser itself
    With Xiaomi's "USB debugging (Security settings)" on (2026-10-22) adb may tap. The rescue now
    taps OK on "Allow ... to access the USB device?" (uiautomator can't read the screen while the
    game animates, so by position, only while UsbPermissionActivity has focus), and after an
    unplug, when Chrome has lost a device's permission, opens the Connect chooser with a
    user-gesture click over CDP and taps the device, Connect and OK. It also brings Chrome to
    the front first: a page behind the home screen doesn't draw and looked like the white screen.
    Verified on the Redmi after the SIM swap unplugged everything: the display helper started
    (o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
2026-10-22 Rescue: a hands-off watch, and --check really only looks
    tools/watch.sh runs rescue.py --check every 5 minutes and writes one line per check to
    rescue-report/watch.log (screenshot + game log kept on a failure), for a long unattended
    test: how long does the machine last without anyone stepping in. --check no longer brings
    Chrome to the front or writes to the game log.
    First line 10:18: all green, game ready, belt at START.
2026-10-22 Tankeleseren: a plan-B game for children on the same machine
    The maker worried Kvitteringsspillet is too confusing and wanted a second game that is
    obvious at once, fun for children, with the printed text only a bonus. Tankeleseren
    ("the mind reader"): think of one of the eight animals on the START screen; the IBM
    display asks 2-4 yes/no questions; the belt jumps to the animal it worked out and asks
    "ER DET EN KATT?". JA = the win light, bell and a "proof" receipt (picture + one fact);
    NEI = the belt goes on to DU LURTE MEG! and a diploma with a box to draw your animal in.
    - game/tankeleserData.js: animals, the question tree and texts — everything to edit
    - game/tankeleser.js: the game (s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
2026-10-22 Kvitteringsspillet: a calmer display and a clearer receipt
    After a lot of user testing the maker wanted less noise in what the machine says.
    IBM display: the left 18 characters are text, one line per row; the right 2 columns are one
    big arrow over both rows (up = the receipt, right = the question on the scroll, down = the
    buttons), drawn by the helper as 4 custom characters (slots 4-7, redefined only when the
    arrow changes; /show?pil=up|right|down|none). Nothing blinks or takes turns any more.
    Playing: LES SPØRSMÅLET (right) or LES KVITTERINGEN (up) on top, the kroner and friends
    below, updated when a choice is made. The clock only in the last 30 s (SKYND DEG! 0:27).
    Receipt: each answer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
2026-10-22 Strip: the screen number seen from above, even line breaks, JA/NEI like the buttons
    From the maker's photo of the window: the window is seen a little from above, so "1/10" at
    the very top hid under its edge (now bigger and lower); the question broke badly ("Livet er
    mange / valg.": now the narrowest width giving as few lines, so lines come out even); and
    the answers are two boxes matching the real buttons, JA white with black letters, NEI black
    with white (question 2: JA / VENNER, NEI / PENGER on two lines).
    Verified: screens 1, 2 and 4 rendered in a browser with the real pictures.
2026-10-22 Kvitteringsspillet: a START screen, smaller lead-ins, a bigger arrow
    The maker's requests after looking at the strip and the display:
    - A START screen before question 1 on the strip (KVITTERINGS-SPILLET, "Ikke gå i minus!",
    "For å starte:" JA / NEI). A first press now only starts: the receipt's top prints and the
    belt brings question 1 — before, the press meant to start also answered "Vil du bli født?".
    createKvitteringGame(io, manus, { intro: true }); 11 screens, the strip ~150 cm.
    - Questions 1 and 2: the lead-in lines small, only the question itself big, and every
    question the same size (56 px).
    - The IBM display: the arrow over 3 columns instead of 2 ("too little room"), 15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
2026-10-22 Strip: question 2's boxes say just VENNER and PENGER
    The maker is taking the JA/NEI signs off the buttons; which box is which button is clear
    from place and colour (left white, right black), so question 2 drops the JA/NEI over its
    answers.
    Verified: screen 2 rendered in a browser.
2026-10-22 IBM display: TRYKK PÅ EN KNAPP / FOR Å STARTE when ready
    The JA/NEI signs came off the buttons, so the start text no longer names them (the
    maker's wording; exactly the 17 characters left of the arrow).
2026-10-22 IBM display: no cursor; bigger lead-in text on the strip
    The display showed an underline cursor under the bottom row's first letter (FOR read as
    EOR). Its commands aren't published; worked out by trial with the maker watching:
    0x01's length byte places the cursor (0-19 along the top row, 40 = off the screen, 60 is
    rejected) and every line write puts it back at the bottom row's start; 0x10's length byte
    is its shape (0 underline, 1+ blinking block). The helper now sends 0x01 len 40 after every
    line write. Only 0x01 and 0x10 of 0x00-0x3F/0x83-0x8F are accepted (the probe's endpoint is
    gone again). Noted in tools/ibmlcd.py.
    The page sends the display's lines again every 5 s even when unchanged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
2026-10-22 IBM display: an empty first column for the cursor that can't be hidden
    The last commit tried to park the cursor off the screen with 0x01; on the machine that
    blanked the top row. More trials with the maker watching: 0x01 blanks the top row whatever
    its length or data (it does move the cursor), every line write puts the cursor under the
    bottom row's first cell, and nothing found switches it off. So the display's first column
    is kept empty for it — a small underline alone in the corner instead of under the first
    letter (FOR read as EOR) — and the text is 16 characters: TRYKK EN KNAPP / FOR Å STARTE,
    TAKK FOR SPILLET. The helper sends no cursor commands. Notes in tools/ibmlcd.py corrected.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
2026-10-22 Kvitteringsspillet: "Vil du starte?", a GRATULERER screen, the machine's own photo
    The maker's requests for the strip:
    - START screen: "Vil du starte?" instead of "For å starte:", as big as the questions.
    - A last screen after 10/10: GRATULERER! / Spilleieren er nå på vei for å gratulere deg.
    createKvitteringGame(..., { finale: true }): a win moves the belt on to it while the end
    of the receipt prints; a loss doesn't. 12 screens, the strip ~160 cm.
    - Question 10's picture is now the maker's photo of the finished machine
    (bilder/10-kvitteringsspillet2.png, 700 px; the 7 MB original is in bilder/original/,
    git-ignored), swapped in kvitteringTegning.js (NYTT_BILDE) rather than in ma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
2026-10-22 Receipt: what you bought, why you lost, and the end out of the slot
    From the maker's user tests:
    - A purchase question's answer said only "3. Ja" / "3. Nei". Now its line names the thing
    ("3. Labubu ---- 14 år", the Ja answer's first expense, cut on whole words to fit) with
    KJØPT or IKKE KJØPT (bold) under it. Other questions keep their answer (Ja, Venner).
    - A loss now says why, big: DU GIKK TOM FOR PENGER! / DU GIKK TOM FOR VENNER! (and TIDEN ER
    UTE!), then one plain line, instead of SPILLET ER TAPT; the display says TOM FOR PENGER! etc.
    - The end of the receipt stayed inside the machine after a loss: the feed before the cut is
    now 15 mm + the answer feed (40), so the last lines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
2026-10-22 Question 10's picture lighter; the display says TRYKK FOR / Å STARTE
    The photo of the machine printed too dark on the strip: now gamma 0.5, brightness 1.2 and an
    outline (chosen from five variants rendered side by side). The display's ready text is the
    maker's "Trykk for å starte", over two lines (16 characters each).
2026-10-22 Kvitteringsspillet's script rewritten for children
    After the user tests the maker approved these changes to Aksel's script (game/manus.js):
    - Shorter, simpler story texts (one or two sentences; no "ROI", Napoleonic wars,
    "skjellsettende", "vinteropplag"...). The questions, prices and pictures are unchanged.
    - Kroner and friends are both always shown: question 2's "visning" steps are gone, and the
    end shows both totals. (Question 2 itself is next — a proposal is with the maker.)
    - You only lose by running out of money or friends: rowing "Nei" now hurts your back and the
    rescue boat costs 25 000 kr — more than anyone can have by then (at most 22 100), so it
    still always loses, now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
    [kvitteringMotor.js]
2026-10-23 Keep the strip pictures out of git
    The repo goes public for the Instructables post; some of the strip's pictures have unclear
    rights and the strip is already printed. History was rewritten (filter-branch) to drop
    bilder/; the files stay on the Mac, which serves them to the phone as before.
2026-10-23 Diagrams for the Instructables post
    The system overview and the wiring as SVG + 1520 px PNG (rendered with headless Chrome),
    ready to upload to the post's How It Works and Wire the Electronics steps.
2026-10-23 More pictures for the Instructables post
    All laser-cut sheets on one page, four screens of the scroll (start, questions 1-2, the end;
    no picture screens, for their rights) and a real losing receipt, rendered from the game's own
    drawing code with headless Chrome.
2026-10-24 A watcher that brings the IBM display back by itself
    At the festival the display's USB plug is loose: every time it drops out the helper loses it
    and the display only shows its power-on OK. tools/watch_display.py asks the game page every
    10 s whether it reaches the display, and after two misses restarts the helper in Termux and
    taps Android's Allow-USB box (rescue.py's start_helper). Verified: the helper restarted
    from the Mac after the plug dropped, page sees the display again.
2026-10-24 A micro:bit freeze mid-step no longer sends the game back to START
    At the festival a player answered question 9 right and the game went back
    to START. Not the extra screens: the phone log shows the micro:bit's
    heartbeat stopping for 5 s right as the belt was to step to 10 (the old
    freeze, three times today). The watchdog reset the board fine, but a reset
    during any move meant game.reset().
    Now belt.js remembers the move the board hasn't finished. After the reset,
    a step up gets POS:<screen it left> and BELT:STEP again (the firmware stops
    at the next mark whether the belt had moved off its mark or not), with the
    board's full time again; a rewind is sent again. Other moves still go back
    to ST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
